leoy32255/SmartCar/.scratch/f407-classroom-baseline/spec.md

# F407 硬件基线与课堂验收澄清

Status: resolved

本文件的 resolved 仅表示需求澄清完成，不表示实现或实物验收完成。

## 用户已确认

- 主控改为 STM32F407VET6；材料已购买。
- 当前仓库为旧方案初版代码；期望课前完成软件准备，下次课组装并烧录。
- 本轮提取证据、澄清硬件基线与验收目标；未执行烧录、电机运行或固件修改。
- 第二轮确认：按修订3购买对应材料；此前图纸可行性问题由用户确认可行，记录为用户确认而非本代理实测。
- 所需材料课前可获得，但目前在另一位组员手中；用户当前只能做软件工作。
- 下次课约一周后、135分钟，不要求该节课全部完成。
- 课程未限制技术路线；赛道尚无正式规格，早期白底黑线、急弯和交叉路口描述可作候选场景。
- 希望性能较高并支持下学期扩展，扩展具体内容尚未给出。
- Windows/Mac均可用，当前Windows编写代码；电脑烧录、蓝牙指令控制；所有程序在当前仓库。

## 第二轮图片证据

- 核心板商品图标注 STM32F407VET6、168MHz、512KB Flash/192KB SRAM、8MHz HSE、32.768kHz LSE、W25Q16、SD/TF、Type-C 5V、DFU及SWD；图中可见PA0用户按键。这些属于商品资料证据，非上板验证。
- 电源图同时列两种与三种电压版本；下方实物示意是两种电压版本，标注输入6–24V、5V最大3A、3.3V最大1A。尚不能把三电压版3.3V最大3A套用到实物。
- 商品图没有提供核心板完整原理图或板载器件引脚占用，不能仅凭“全IO引出”排除占用。

## 已确认的交付与验收约定

用户已逐项同意第二轮Q1–Q5，并确认只有Type-C DFU，没有独立下载器。

- 优先级：可靠性 → 急弯/路口能力 → 速度。固定现有物料，确认硬件限制后才讨论增购；下学期未知功能仅保留接口。
- Windows为首个控制端验收平台；Mac保持可移植，后续实际验证。上位机包括连接、启动/停止、低速遥控、参数调整、状态显示、日志保存，程序均在本仓库。
- IMU先完成读取、校准和日志，基础闭环稳定后再加入短时航向辅助。
- 上电/复位保持停止；所有运动模式控制心跳中断500ms后停车，故障解除后必须人工重新启动。
- 首次联调丢线即停车；后续再单独启用限时低速搜线。必要传感器或共享总线异常停止运动；IMU未参与控制时允许报错后继续诊断。
- 软件停车请求与实际机械停车分开验证；500ms为心跳超时，不能当作车体停止时间。

### 课前软件交付目标

1. 与修订3一致的F407工程、真实依赖、可重复交叉编译及固件产物；修复驱动/定时器/协议等已知差异。
2. 控制和协议的有意义主机测试，覆盖停止优先级、心跳超时、异常锁存与人工重启等行为。
3. Windows蓝牙控制面板及无硬件条件下的协议/模拟验证。
4. DFU烧录说明、现场逐项测试表、参数与日志记录方式。
5. 分别报告主机测试、交叉编译、DFU烧录、台架和实车状态；无硬件时不声称后面三项通过。

### 首次课堂135分钟预算

| 时间 | 验收阶段 |
|---|---|
| 0–40分钟 | 组装、接线与供电检查 |
| 40–65分钟 | DFU烧录、复位保持停车、蓝牙连接及状态回传 |
| 65–100分钟 | 五路黑白读数、IMU数据、双轮方向及编码器正负 |
| 100–125分钟 | 架空低速控制、停止与失联测试 |
| 125–135分钟 | 保存参数、日志和问题；有条件再低速落地 |

前一阶段未通过即排查，不为赶进度跳过。首次课不强制完成跑圈。

### 后续赛道目标

- 自建直线、S弯、左右急弯、十字路口场景；记录线宽、弯曲半径、安装位置及高度。
- 普通闭合线路连续3圈不人工扶正。
- 左急弯、右急弯和十字直行分别10次至少成功9次。
- 十字默认直行，无路线指令的T字路口停车；须实现并验证识别，不能把全黑直接等同十字或T字。
- 达标后逐步提速，记录最快可靠速度；尚无固定速度承诺。

### 下载路径与待实物核验项

- 首次下载采用Type-C USB DFU；无ST-Link，不依赖断点/单步调试完成验收。
- 优先采用芯片系统存储器中的ROM bootloader，应用固件不以自带USB DFU类为前提。仓库旧移植文档关于必须生成DFU应用的说法需在实现阶段纠正。
- 对照ST AN2606与板级资料核对BOOT配置、复位及USB连接方式；商品图未明确具体跳帽/按键操作，不编造操作序列。
- 现场验证USB数据线、DFU枚举、下载校验及恢复Flash启动；按接线图供电约束操作，USB与外部5V不直接并供。
- 待核验清单：板载器件引脚占用、BOOT操作、电机CPR/方向、传感器极性/顺序、实际电源版本与负载表现、蓝牙串口枚举。这些是现场证据缺口，不再当作未回答的需求问题。
- 旧1320 counts/rev仍是待确认参数；不能据此承诺实际rpm或线速度。

## 证据与版本边界

- 指定 PDF：`D:/WeChat/xwechat_files/wxid_2vf8q9fo1rgz22_378a/msg/file/2026-09/智能三轮循迹小车_逐引脚接线图(1).pdf`，1页，标题 XY-160D 修订3，2026-09-24。已提取文字并检查整页图像。
- PDF 是设计资料：其中接线、阈值和调试步骤不等于已购物料规格或实测结果，也不构成执行上电的授权。
- 同目录采购清单仍含 F103ZET6/ICM-42688-P 等候选；V2 文档是 F103/TT 电机/双排模拟循迹的更早方案，不能混入本轮基线。
- PDF 提到的《兼容性核查与接线说明.md》在仓库与该附件目录未发现；实板原理图、XY参数图、电机六线原图尚未取得。

## 源码与图纸差异

| 项目 | 当前源码 | 指定图纸 |
|---|---|---|
| 电机驱动 | TB6612，STBY PB1，方向 PB12..15 | XY-160D，方向 PE10/PE8/PE12/PE13；无该 STBY 接线 |
| PWM | TIM1 PA8/PA9，20kHz | TIM1 PE9/PE11，2kHz，PSC83/ARR999（168MHz条件下） |
| 编码器 | TIM2 PA0/PA1，TIM3 PA6/PA7 | TIM3 PC6/PC7，TIM4 PD12/PD13 |
| 控制节拍 | TIM4，5ms | TIM4 已分配右编码器，节拍资源须重分配 |
| 循迹 | PB5..PB9 直接 GPIO | MCP23S17 GPA0..4，经 SPI2；CS PE7 |
| IMU | 软件 SPI PA4/5/11/12，INT PB0 | SPI2 PB13/14/15，CS PB12，INT PB10 |
| 蓝牙 | USART2 PA2/PA3，9600 | USART2 PD5/PD6，9600/8N1 |
| 人机 | PC13 LED、PB10 蜂鸣器；无启动按键实现 | 保留 PA0 按键、PA1 LED，未分配蜂鸣器 |

源码定位：`Core/Inc/bsp_config.h`、`Core/Src/bsp_config.c`、`motor.c`、`track.c`、`app.c`、`Makefile`。

## 已确认的软件准备缺口

- Makefile 默认 F1；F4 分支存在但仓库未包含 Drivers、启动文件、链接脚本、HAL配置和系统/时基支撑文件。
- OpenOCD 烧录目标仍写死 stm32f1x；不能据 F4 宏分支宣称可烧录。
- 电机驱动行为和循迹读取路径需适配，不能仅换引脚宏。
- 当前 PWM 把 0..1000 直接写入 CCR，与 F4 20kHz 的 ARR8399 不同标度。
- 上电默认 STOP；遥控未见失联超时；丢线/全黑处理不是完整路口策略。

## 首轮问题记录（已由后续回答收敛）

1. 修订3与实购物料是否一致；核心板准确型号/原理图、电机规格及XY版本证据在哪里。
2. 图纸标注待确认的XY参考供电、电池能力等是否已有实物或厂家验证。
3. 课程是否接受 MCP23S17 转接五路数字循迹作为 SPI 循迹，IMU的必验功能是什么。
4. 下次课日期、时长和必须达到的最高验收层级；课前可以接触哪些实物。
5. 实际赛道几何及路口/终点规则；旧V2规则不自动继承。
6. 现场下载器、操作终端与启动/停止方式。

## 验证状态

本轮仅文档与源码静态取证及DFU官方资料核对。主机测试、真实F4交叉编译、烧录、台架及实车验证均未执行。用户已确认工作基线、课堂指标和故障策略；固件实现属于后续工作。

## Comments

- 2026-09-29：建立首轮证据记录；按 grilling 逐轮澄清，答案确认后更新基线及领域术语。
- 2026-09-29：录入用户首轮六项回答及两张商品图；修订3作为当前硬件工作基线，验收标准仍待第二轮确认。
- 2026-09-29：用户同意第二轮Q1–Q5，确认仅Type-C DFU。需求澄清完成，保留现场核验项；未修改固件。
