leoy32255/SmartCar/.scratch/unified-bringup-guide/spec.md

# 统一新手联调流程

Status: resolved

## 目标与边界

整理 docs，形成一份不依赖旧文档阅读经历、也不预设单片机经验的完整操作流程。以当前 F407 源码、修订3 PDF、2026-10-20 用户补充为准；保留历史证据并隔离过时操作。更新 README 与旧入口，不修改无关编辑器配置或 vendor 检出目录。不执行烧录、电机运行、提交或推送。

## 当前用户确认

- 已下载 STM32CubeMX 和 STM32CubeProgrammer，Programmer 尚未检测到核心板。
- 旧线连接出现 U 盘，新数据线已购买但尚未测试。
- 核心板型号 STM32F407VET6；核心板只有孔，未焊排针。
- 各模块及模块、核心板、电脑间的连接尚未实施；部分接口缺适配线。
- 有万用表、ST-Link V2、焊接工具；USB 转 TTL 模块似乎没有，可按需购买。
- 商家表示不懂，未取得可用的 BOOT/DFU 操作说明。
- ST-Link 具体实物针序、供电脚性质、缺线接口、模块实际供电/输出电平与板载占用仍待核验。

## 验收

1. 一份主指南覆盖当前状态、术语、线材与焊接、工具配置、SIM、裸板下载、真实通信、供电、完整接线、传感器、电机与赛道，按前提/动作/预期/失败停点推进。
2. 现行主入口没有 F103/TB6612 或旧里程碑操作；历史记录有日期与适用范围。
3. 引脚、参数与 GUI 按钮同源码；USB DFU、SWD 下载和 USART2 通信分清。
4. 主机测试、交叉编译、历史 UI 反馈与未做的硬件验证分开记录；检查文档链接及归档完整性。

## Comments

- 并行只读文档与源码审计完成；未发现本任务必须修改的功能代码。
- 修订3 PDF 已检查完整单页与文字；商品图仅作板卡资料，不替代实物针序或 BOOT 电路。
- 已完成统一流程、README导航、集中引脚表、14份历史原文快照与11个旧入口转向；本任务不删除历史证据。
- 新手审阅发现原面板未显示device_ms/deviation，已补两项只读显示，并标明请求PWM不是实际电气回读。无固件逻辑修改。
- 独立审阅提出的阶段供电依赖、诊断灰按钮/拒绝验证、丢线故障验证阶段、无示波器时序边界均已修正。
- make -j8 test 22项通过；本次双固件已最新未全量重编。新增显示的脚本语法和render读数检查通过；浏览器工具不可用，新增UI未做实际渲染验收。详细边界见主流程第12节。
- 2026-10-20用户随后反馈4.2工具版本正常、4.3全部OK、4.4完成并提供SIM快照。已核对快照和同日会话日志，原样保存截图/快照，更新阶段B为完成；参数写入及具体焦点操作仅据用户反馈，未混称独立复现。硬件阶段不推进为已完成。
