leoy32255/SmartCar/CONTEXT.md

# 智能三轮循迹小车

本项目面向双驱动轮加万向支撑轮的小车，完成循迹与电脑蓝牙控制，并为后续课程扩展保留空间。

## Language

**硬件基线**：本轮开发采用的已购物料与对应接线方案，当前以用户确认的修订3为准。采用方案不等于完成实物验证。

**课堂验收**：在课堂实物条件下，按约定步骤观察并记录模块或整车是否满足目标；可分多次课完成。
_Avoid_: 编译通过即验收通过

**循迹模式**：由线路传感器观测引导小车沿地面线路行驶的工作模式。

**遥控模式**：由电脑通过蓝牙下发运动指令控制小车的工作模式。

**课前软件验证**：在未连接小车实物时对程序逻辑与固件构建进行的验证，不包含电机、传感器或赛道表现。
