leoy32255/SmartCar/docs/课堂135分钟检查表.md

# 课堂检查表：入口已合并

当前操作、工具配置、接线、下载、面板使用及测试记录统一见[上手与实物联调流程](上手与实物联调流程.md)。从当前进度开始执行即可，无需先读旧说明。

本页保留旧链接入口。[原文历史快照](archive/2026-10-20/课堂135分钟检查表.md)仅供追溯原阶段证据，不作为现行操作步骤。
