leoy32255/SmartCar/docs/archive/2026-10-20/F407电机驱动迁移.md

> 历史快照：2026-10-20整理时归档，保留原阶段状态；下文不代表当前操作流程。当前执行请读[统一流程](../../上手与实物联调流程.md)。原正文保留，文档链接仅调整为归档后的可达路径。

# F407 板级与 XY-160D 电机驱动迁移

日期：2026-10-05。任务：`.scratch/f407-classroom-baseline/issues/02-board-motor.md`；
依赖已resolved的01最小构建。本轮只完成板级/电机接口，未接入闭环、传感器驱动、
运动协议、500ms心跳或人工故障重启状态机，也未执行烧录或电机操作。

## 前两步核对

已读取硬件spec、01任务和2026-09-29构建记录，并重新提取/检查修订3PDF整页。
附件图中的步骤是开发顺序；PDF中的接线与调试步骤作为设计证据，不是本轮上电授权。
外部指定spec与工作树spec的需求一致；初始工作区干净。

- 已有：真实HAL/CMSIS、F407启动/链接、8MHz HSE至168MHz、修订3引脚、唯一IRQ归属。
- 冲突已解决：TIM1专属PWM，TIM3/TIM4左右编码器，TIM6 5ms控制节拍，SysTick仅HAL 1ms。
- 变更前当前工作目录真实重建成功，原有5项测试通过，Flash7172B、普通SRAM2528B。
- 原有缺口：只有11/PWM0初始化，无XY-160D运行接口；旧TB6612驱动不编入F407。
- 保留现场证据缺口：核心板占用、BOOT、XY参考电压/信号电平、电源、电机CPR与方向。

## 接口与输出约定

`motor.h` 在F407选择 `motor_f407.h` / `Core/F407/motor.c`；旧F1驱动与接口保持原样。
配置集中在 `bsp_config.h` 转入的 `bsp_f407.h`，驱动不使用旧STBY或蜂鸣器引脚。
所有接口在 `Bsp_Init()` 完成后由主循环串行调用，不在ISR并发调用。

| 调用/输入 | 行为 |
|---|---|
| `Motor_Init()` / `Motor_Stop()` | 两轮11/PWM0，撤销使能并清除记录 |
| `Motor_Enable(0)` | 同Stop |
| `Motor_Enable(1)` | 允许新指令，不恢复被丢弃的指令；重复使能不改变当前输出 |
| 禁用时 `Motor_SetPWM(left,right)` | 丢弃指令，保持停车 |
| 单轮0或绝对值1..49 | 该轮11/PWM0，不将小指令放大成5% |
| 绝对值50..950 | 原值输出，即5%..95% |
| 绝对值951..32768 | 限制为950，含INT16_MIN，不溢出取负 |
| 正/负指令 | 默认方向10/01；这是软件极性约定，车前进方向需实物校准 |
| `Motor_GetPWM` | 返回限幅后的带符号指令（方向校准前），不是测速；允许空指针 |

`BSP_MOTOR_LEFT_INVERT` / `BSP_MOTOR_RIGHT_INVERT` 默认为0，各自可改为1。
左右PE10/PE8、PE12/PE13控制方向，PE9/PE11提供TIM1_CH1/CH2 PWM。
`PSC=83, ARR=999`，168MHz /84 /1000 = 2kHz。
千分比按 `abs(command)*(ARR+1)/1000` 转换，因此50/950对应CCR50/950。
暂不提供100%或00动态刹车接口；停车采用图纸要求的11高阻滑行，机械减速时间待实测。

## 换向与停机

HAL开启OC比较预装载，单写CCR0并不保证旧占空比立即失效。任一轮方向状态改变
（含零与非零转换）时，先同时置两轮11，再写两路CCR0并发TIM1 UG刷新零值。
之后才选择新的10/01方向、写新CCR；新占空比在后续自然更新事件生效。
因此这类操作会短暂中断另一轮PWM；相同方向的调速不发UG、不重置PWM相位。
本实现不承诺固定机械换向等待时间，也不把软件顺序当成实测的电气死区。

`Bsp_MotorStop` 是低层初始化/驱动助手，不更新电机软件状态；应用停止须调用
`Motor_Stop`。`Error_Handler` 仍关中断并强制方向11、PWM GPIO0后停留。
上电至软件执行前的状态仍依赖图纸的外部方向上拉。

主程序只调用 `Motor_Init` 后等待中断，不调用Enable/SetPWM。ARM编译器编译完整
`motor.o`；链接器按 `--gc-sections` 删除默认固件未引用的使能/运动函数。
该产物仍是停车诊断固件；未来控制集成须显式调用接口并实现spec规定的安全策略。

## 验证记录

- 用户确认测试接口：电机公开API到方向/PWM、限幅、零值、默认禁用/重新使能；
  沿用板级初始化和构建产物接口。审查基线为 `4be551ed7bd65c7d99cf03c5ba6589a57f0cdfb0`。
- TDD：默认禁用测试先因缺少API链接失败；方向/限幅测试先因输出不符失败；
  换向刷新测试先因缺少UG失败；实现后相应测试通过。
- 初次运行失败断言触发MinGW/Windows异常弹窗，该次返回状态不足以证明测试完成。
  已改为非交互错误退出、捕获输出、20秒超时和完成标记检查，并实际复现断言失败退出1。
- 主机执行真实BSP/电机源码，使用ST类型与模拟HAL/MMIO；方向写入处检查无00瞬态，
  且选新方向前两CCR为0并已请求UG。四种左右极性组合均执行同一行为测试集。
  不执行真实HAL硬件逻辑，不模拟模拟电路或定时器波形，不能证明电气安全/物理时序。
- `make -j8 test`：9项通过（1项板级、4项电机极性组合、3项产物、1项依赖完整性）。
  主机编译器MinGW GCC8.1，电机测试使用 `-Wall -Wextra -Werror`；未以跳过计为通过。
- 真实交叉编译：GCC for STM32 14.3.1，Cortex-M4硬浮点，真实71个固定ST依赖，
  `make -j8` 成功，无新增编译/链接警告。未用 `.ci_check` 桩替代固件构建。
- ELF/HEX/BIN/MAP位于 `build/F4`。Flash7220/524288B，普通SRAM2536/131072B
  （含2048B栈预留），CCM0。BIN7220B，SHA-256
  `4ede02f8c06120dd0203622aa105087268e2d6ddaee88caac845b5b53ef5e525`。
  ELF SHA-256 `3cde28414105a67eb04f7f2959fc7a18b1aaeaae95b9ad2d3719a3973390c7ff`
  （包含本地调试路径）。本轮未额外宣称独立导出/跨机复现。

## 双轴代码审查

两个独立只读审查，以 `4be551ed7bd65c7d99cf03c5ba6589a57f0cdfb0` 为固定基线。
因提交阶段遇到工作树元数据权限/默认Git身份问题，审查使用
`git diff 4be551ed7bd65c7d99cf03c5ba6589a57f0cdfb0 -- .`（含已暂存新增文件和工作区修正），
未将空的提交差异送审。审查员未独立运行测试或硬件；执行结果来自上文主代理记录。

### Standards

0项。未发现违反AGENTS.md、当前F407模块边界、集中配置及验证证据要求的变更，
也没有值得要求修改的代码异味。核对了F1接口保留、配置集中、停机与换向刷新顺序、
同方向调速保留相位，以及主机模拟和实物验证的区分。

### Spec

0项。未发现本票范围内的要求遗漏、越界或实现错误。核对了TIM6/TIM3/TIM4归属、
2kHz与接线、限幅/极性、默认禁用、Stop与重新使能、换向旧PWM刷新、诊断主程序边界。
运动协议、传感器和闭环属于后续任务；未把这些作为本票遗漏。

合计Standards 0项、Spec 0项，无未处理审查发现。

## 待实车验证

1. 核对XY版本允许的3.3V参考供电、引脚占用、方向外部上拉及信号电平。
2. 逻辑供电下检查上电/复位/异常路径的11与ENA0，再用示波器量两路2kHz、5%/95%及换向过程。
3. 架空逐轮低占空比确认左右通道、10/01对应的实际方向、停机滑行与重新使能行为。
4. 手转编码器核对AB方向/CPR，测TIM6节拍与编码器并行工作；闭环留给后续任务。
5. 按已有ROM DFU文档核验板级BOOT操作、枚举/下载/恢复启动。上述项目本轮均未执行。
