leoy32255/SmartCar/docs/archive/2026-10-20/Windows控制面板.md

> 历史快照：2026-10-20整理时归档，保留原阶段状态；下文不代表当前操作流程。当前执行请读[统一流程](../../上手与实物联调流程.md)。原正文保留，文档链接仅调整为归档后的可达路径。

# Windows控制面板

实现位于panel/。这是本机浏览器界面与Python串口后端，不依赖云服务。默认SIM，真实蓝牙使用Windows配对产生的SPP COM口。Mac保留Python/浏览器可移植性，本轮未验证。

## 启动

在仓库根目录使用Python3和本机GCC：

```powershell
python -m pip install -r panel/requirements.txt
python tools/build_simulator.py
python -m panel.server --port 8765
```

HOST_CC可指定GCC路径（见F407最小构建）；SIM需要先生成build/host/smartcar_sim.dll。实际COM仅需要pyserial，不依赖模拟器。打开`http://127.0.0.1:8765`，单个浏览器标签使用；不要同时打开多个控制页面。后端仅绑定127.0.0.1，不向局域网开放。停止服务用终端Ctrl+C；本任务未连接真实COM。

1. 首先选择SIM并连接；连接会发STOP并请求参数，等待实时遥测。
2. 启动循迹或启用低速遥控。遥控按钮按住发送±5 counts/10ms或单轮0/5，松开归零；固件最多接受±10。请勿据此解释为已标定物理低速。
3. 红色停止按钮发STOP；界面以设备遥测显示实际模式，ACK只说明接受/拒绝。
4. 仅停车时调参；应用后请求实际值回读。静止校准需有效IMU样本。
5. SIM可以注入丢线、总线失败、宽线歧义。先恢复传感器，再人工清错，最后重新启动。关闭“发送控制心跳”可验证500ms锁存停车。
6. 断开/重连保持停止。切出页面、隐藏或关闭会尝试STOP并停止页面心跳；网络请求失败时仍依赖固件心跳超时。不要把浏览器发出STOP视为机械已停。

浏览器每100ms请求一次心跳和状态，后端不自行持续发心跳。模拟器复用Core/F407/control.c和runtime.c；轮速为理想目标反馈，不模拟电机、传感器电气或无线链路。控制器与真实App测试另有独立覆盖。

## 日志和参数

每次连接自动建立`logs/日期-时间-微秒.jsonl`；每行一个UTF-8 JSON对象，包含UTC time与kind。connect记协议/固件系列及端口，command记命令字和十六进制载荷，rx记原始帧载荷，telemetry记模式/故障/五路/编码器/IMU原始及零偏，parameters记六项实际参数，disconnect记结束。日志自动flush，目录被gitignore忽略；写入失败显示错误并停止本地发送。日志会话头不证明实际烧录版本，须在课堂表另记BIN哈希。

“保存参数快照”下载JSON（含当前遥测、参数、端口、日志路径与时间）。设备参数仅在RAM，复位恢复app_config_f407.h默认值。将已验证参数抄入课堂模板，确认后再改源码默认；不要把未验证值标为标定结果。

## 排错

- SIM加载失败：先运行build_simulator.py，检查HOST_CC/平台位数；不要把缺库当串口故障。
- 端口列表只有SIM：检查pyserial安装、Windows配对与SPP枚举；刷新列表。未枚举不是固件协议结论。
- 命令拒绝：查看故障、样本新鲜度、当前模式、参数范围；先停车/恢复条件/清错，再人工启动。诊断固件永远拒绝运动模式。
- 无遥测/数据显示过期：面板500ms无有效遥测标过期并禁止启动；检查COM、9600/8N1、帧版本。切勿盲目反复启动。

## 验证状态

2026-10-08最终状态：用户已反馈Windows SIM清单1–6通过；第一次取消心跳时已停止，所以无心跳故障符合运动模式超时检测语义，第二次运动中超时符合预期。日志时序、参数快照与四组同源C模拟器定时复现已核对，未发现需要修复的功能缺陷。05/06标记resolved。此为用户界面实测与代理自动验证的合并证据，代理未亲自完成浏览器操作，浏览器名称/版本未知。源码仍为4c90a5b；此前22项自动软件验证、双目标构建及独立导出BIN/HEX一致性证据有效，本次仅文档收尾，不重复测试。真实蓝牙、DFU、台架和实车未验证；未推送、未烧录、未运行电机。 详细日志与复现见[心跳取消差异诊断](心跳取消差异诊断.md)。

### 历史：2026-10-07 用户分批实测进度（后续已完成）

用户反馈已在VS Code运行PowerShell命令并打开URL，步骤1–3可以完成。记录为用户实测反馈，说明本机页面已可访问；不是代理亲自操作或逐项采集的证据。步骤4–6尚待结果，浏览器名称/版本待补充，不关闭整体UI验收。

### 步骤4–6详细操作与通过标准

全程只选SIM，保持单个控制页面。以“设备状态”的遥测为准，不能只看“命令已接受”。每个场景开始前勾选“发送控制心跳”、点击“恢复传感器”，必要时“清除故障”。

#### 4. 停车调参、校准和快照

1. 点击“停止”，确认模式为“停止”、PWM为`0 / 0`。
2. 在“停车调参”选择“基础速度”，记下参数区的原值。输入不同的有效值（例如原值5改为6），点击“应用并回读”。
3. 确认下方“基础速度”更新为输入值，再按同样方法恢复原值。全过程应保持停止。
4. 点击“静止校准”，确认IMU区显示“校准：完成”。SIM只验证操作流程，不代表真实IMU校准；不要求观察到短暂的“进行中”。
5. 点击“保存参数快照”，确认下载`smartcar-parameters.json`，打开后确认包含参数、状态、SIM端口与日志路径。打开下载文件可能使页面失焦并请求停车，属预期。

#### 5. 故障锁存和心跳超时

每个故障场景都先“启动循迹”，确认模式为“循迹”，再点击下表故障按钮。

| 故障按钮 | 预期故障显示 | 停车结果 |
|---|---|---|
| 丢线 | 丢线 | 模式停止，PWM为0 / 0 |
| 共享总线故障 | 传感器失效 | 模式停止，PWM为0 / 0 |
| 宽线 / 路口歧义 | 线路歧义 | 模式停止，PWM为0 / 0 |

每次故障后依次检查：点击“恢复传感器”后故障仍保留且仍停车；点击“清除故障”后显示“故障：无”但仍停车；只有再次“启动循迹”后才能恢复循迹。三个场景分别重复完整流程。

心跳场景：正常循迹时取消勾选“发送控制心跳”，保持页面前台等待约1–2秒；应显示“停止”、PWM为`0 / 0`及“心跳超时”。重新勾选心跳后故障应仍锁存；清除故障后仍停止；人工启动后才恢复。肉眼操作验证超时停车及锁存，不用于证明精确500ms时序。

#### 6. 重连与切换窗口

| 场景 | 操作 | 通过标准 |
|---|---|---|
| 断开重连 | 启动循迹→断开→连接→等待“实时” | 遥测模式为停止，PWM为0 / 0，不自动启动 |
| 切换窗口 | 启动循迹→切换到VS Code等待2秒→返回页面 | 模式为停止，PWM为0 / 0，不自动恢复；若出现心跳超时，另行记录并清错 |

测试结束点击“停止”。另检查页面显示的日志路径对应文件存在且非空；具体日志字段定义见“日志和参数”。

#### 结果记录（未填不代表通过）

```text
操作者／日期：
浏览器名称／版本：
1–3：用户已反馈可以完成
4：参数回读___；恢复原值___；校准___；快照下载及内容___
5：丢线___；总线故障___；宽线歧义___；心跳超时___
   恢复传感器不启动___；清错不启动___
6：重连保持停止___；切换窗口后保持停止___
日志文件存在且非空___
失败项的操作及实际显示：
```

### 最终验收结果（2026-10-08整理）

用户已反馈1–6通过，包括参数回读/校准/快照、故障模拟、运动心跳超时、重连与切换窗口。第一次取消心跳时已停止，不新增心跳故障符合预期。操作者为用户，浏览器名称/版本未提供。代理核对的快照采集于2026-10-07 22:41:10.843（北京时间），SIM、mode0/fault0、PWM0/0、health7、参数[4,20,5,20,2,0]；[原样验收附件](../../reference/smartcar-parameters-20261007.json)。原始日志保留于logs，时序摘录及四组定时复现见[诊断记录](心跳取消差异诊断.md)。上方空白结果模板供后续验收复用，不表示此次用户实测仍未完成。
