leoy32255/SmartCar/docs/archive/2026-10-20/引脚分配.md

> 历史快照：2026-10-20整理时归档，保留原阶段状态；下文不代表当前操作流程。当前执行请读[统一流程](../../上手与实物联调流程.md)。原正文保留，文档链接仅调整为归档后的可达路径。

# STM32F407VET6 修订3引脚分配

当前配置入口：`Core/Inc/bsp_config.h` → `bsp_f407.h`，实现 `Core/F407/bsp.c`。依据2026-09-24 XY-160D修订3接线图与用户确认spec；以下配置尚未实物验证。

| 功能 | 引脚 | 当前配置 |
|---|---|---|
| 左/右PWM | PE9 / PE11 | TIM1_CH1/CH2，AF1，2kHz，默认CCR=0；驱动限幅5%–95% |
| 左方向1/2 | PE10 / PE8 | 普通输出，默认11高阻停车；驱动10/01 |
| 右方向1/2 | PE12 / PE13 | 普通输出，默认11高阻停车；驱动10/01 |
| 左编码器A/B | PC6 / PC7 | TIM3_CH1/CH2，AF2，TI12 |
| 右编码器A/B | PD12 / PD13 | TIM4_CH1/CH2，AF2，TI12 |
| 共享SPI2 SCK/MISO/MOSI | PB13 / PB14 / PB15 | AF5，Mode0，656.25kHz |
| IMU CS / INT | PB12 / PB10 | 默认CS高，事务时拉低；INT使用EXTI15_10的line10 |
| MCP23S17 CS | PE7 | 默认高，事务时拉低；MCP全输入上拉及五路采样 |
| 蓝牙TX/RX | PD5 / PD6 | USART2 AF7，9600/8N1 |
| 循迹OUT1..5 | MCP23S17 GPA0..4 | 外部接线，后续驱动只使用低5位；不再用PB5..9 |
| 保留 | PA0、PA1、PA11/12、PA13/14、晶振 | 本目标不配置按键、LED、USB、SWD及晶振GPIO |
| 控制节拍 | TIM6，无输出引脚 | 5ms；TIM4专属右编码器 |

无STBY和蜂鸣器接线。上电安全顺序、时钟与IRQ优先级见 [F407最小构建](F407最小构建.md)。板载器件占用、XY参考供电及信号电平仍需现场核验；不把引脚配置成功当作电机停车实测。

## 以下为历史F103配置，不适用于修订3

# STM32F103C8T6 引脚分配表（历史）

> 本文档与 `Core/Inc/bsp_config.h` 中的宏**一一对应**。
> 改引脚时先改 `bsp_config.h`，再同步改本文档，代码逻辑不需要动。

## 一、总表

| 功能 | 引脚 | 外设 / 模式 | 说明 |
|---|---|---|---|
| HSE 晶振 | PD0 / PD1 | OSC_IN / OSC_OUT | 8MHz，PLL×9 = 72MHz |
| SWD 调试 | PA13 / PA14 | SWDIO / SWCLK | **保留，勿占用** |
| **电机驱动** | | | |
| 左电机 PWM | PA8 | TIM1_CH1，复用推挽 | 20kHz |
| 右电机 PWM | PA9 | TIM1_CH2，复用推挽 | 20kHz |
| 左电机方向 AIN1 | PB12 | GPIO 推挽输出 | |
| 左电机方向 AIN2 | PB13 | GPIO 推挽输出 | |
| 右电机方向 BIN1 | PB14 | GPIO 推挽输出 | |
| 右电机方向 BIN2 | PB15 | GPIO 推挽输出 | |
| TB6612 **STBY** | PB1 | GPIO 推挽输出 | **高电平才工作** |
| **编码器** | | | |
| 左编码器 A / B | PA0 / PA1 | TIM2_CH1 / CH2 | 输入浮空，正交 4 倍频 |
| 右编码器 A / B | PA6 / PA7 | TIM3_CH1 / CH2 | 输入浮空，正交 4 倍频 |
| **姿态（软件 SPI）** | | | |
| MPU6500 CS | PA4 | GPIO 推挽输出 | 低有效 |
| MPU6500 SCLK | PA5 | GPIO 推挽输出 | 模式 3，空闲高 |
| MPU6500 MISO | PA11 | GPIO 上拉输入 | |
| MPU6500 MOSI | PA12 | GPIO 推挽输出 | |
| MPU6500 INT | PB0 | EXTI0 上升沿 | 数据就绪 |
| **循迹** | | | |
| 循迹 OUT1（最左） | PB5 | GPIO 上拉输入 | 黑线 = 低电平 |
| 循迹 OUT2 | PB6 | GPIO 上拉输入 | |
| 循迹 OUT3（中间） | PB7 | GPIO 上拉输入 | |
| 循迹 OUT4 | PB8 | GPIO 上拉输入 | |
| 循迹 OUT5（最右） | PB9 | GPIO 上拉输入 | |
| **通信与人机** | | | |
| 蓝牙 TX → MCU RX | PA3 | USART2_RX | 输入浮空 |
| 蓝牙 RX ← MCU TX | PA2 | USART2_TX | 复用推挽 |
| 蜂鸣器 | PB10 | GPIO 推挽输出 | 高电平响 |
| 状态指示灯 | PC13 | GPIO 开漏输出 | 低电平亮 |

## 二、与原设计文档的差异说明

原《硬件设计方案》的引脚表有几处会导致**实际不工作**，本工程做了修正：

### 1. 补上了 TB6612 的 STBY（新增 PB1）

原文档完全没有提到 STBY。TB6612FNG 的 STBY 引脚：
- **低电平 / 悬空 → 整个芯片关断**，IN1/IN2/PWM 怎么给都不转
- 高电平 → 正常工作

这是"接线全对但电机不动"最常见的原因。代码里由 `Motor_Standby()` 控制，
上电默认关断（安全），进入循迹/遥控模式时自动拉高。

### 2. 解决了 PA6/PA7 的外设争用

原文档同时把 PA6 分配给 TIM3 编码器和 SPI1_MISO，自己在表里也标注了冲突。
本工程按"IMU 走软件 SPI"解决：

- 右编码器保留 PA6/PA7（TIM3 硬件正交，4 倍频，不能省）
- IMU 改用软件 SPI，占用 PA4/PA5/PA11/PA12 四个纯 GPIO

代价是 SPI 速率从硬件 SPI 的 ~10MHz 降到 ~3MHz 量级。
但 MPU6500 一次突发读 14 字节只需约 40μs，5ms 周期里占 0.8%，**完全够用**。

### 3. 循迹从 PB6~PB9 调整为 PB5~PB9

5 路模块需要 5 个 IO，原文档只留了 4 个。把 PB5 也划给循迹
（原文档的蜂鸣器移到 PB10）。

### 4. 波特率按模块实际出厂值改为 9600

原文档写 115200，但 JDY-31 出厂默认是 **9600**。
直接按 115200 通信会全是乱码。代码默认 9600，
要改 115200 需先给模块发 `AT+BAUD8\r\n` 永久保存，再改 `COMM_BAUDRATE`。

## 三、避开的复用冲突（设计时已核对）

| 引脚 | 冲突风险 | 处理 |
|---|---|---|
| PB3 / PB4 | JTAG 的 JTDO / NJTRST | **未使用**，避免额外关 JTAG |
| PA15 | JTAG 的 JTDI | **未使用** |
| PB2 | BOOT1，多数板上有下拉电阻 | **未使用**（会影响启动模式） |
| PC14 / PC15 | 32.768kHz 晶振脚 | **未使用**（本工程不用 RTC） |
| PA2 / PA3 | USART2，同时是 USB 相关 | 用作串口，不用 USB |
| PB6 / PB7 | 硬件 I2C1 | 用作普通 GPIO（循迹），不启用 I2C |
| PA0 / PA1 | 同时是 ADC 通道 | 用作编码器，不启用 ADC |

## 四、上电默认状态

初始化顺序刻意保证**上电时车不会乱动**：

1. `Bsp_Gpio_Init()` 先把 STBY 拉低 → TB6612 整片关断
2. `Bsp_Encoder_Init()` 编码器清零
3. `App_Init()` → `Motor_Init()` → `Motor_Standby(0)` + 两路滑行
4. IMU 校准（约 2.5 秒，此间心跳灯常亮）
5. 进入 `APP_MODE_STOP`，电机保持关断

只有收到上位机的 `SET_MODE` 指令（或以后加按键）才会开始动作。

## 五、接线注意事项（来自硬件方案文档 + 实测经验）

- **地线单点汇合**：电机动力地与 MCU 数字地在滤波电容负极单点相连。
  电机电刷火花会造成 MCU 复位，这是最常见的"跑着跑着死机"原因。
- **电机两端并联 104 陶瓷电容**，抑制高频干扰。
- **编码器线**：模块已内置 10kΩ 上拉，若线长超过 30cm，
  建议再加 100Ω 串联阻尼电阻。TIM2/TIM3 的输入滤波器已开到 10 个采样周期。
- **电源**：3S 电池（11.1~12.6V）→ 多路电源模块 → 5V 给 TB6612 的 VCC 和 JDY-31，
  3.3V 给 MCU / MPU6500 / 循迹模块。
  注意该模块 3.3V 输出上限只有 **1A**，5V 是 3A。
- **JDY-31 建议接 5V**（手册要求 3.6~6V），不要接 3.3V。
- **MPU6500 接 3.3V**，模块标称工作电压 DC3.5V 且内部有 LDO。
- **3.3V 只有 1A，接线时算一下**：F103C8T6 约 50mA，
  MPU6500 约 4mA，5 路循迹模块约 5×20mA = 100mA，
  合计不到 200mA，余量充足。但**不要把 5V 的外设误接到 3.3V 上**
  （比如 JDY-31 和 TB6612 的逻辑 VCC 都要 5V）。
- **换 F407VET6 后供电方式会变**：那块核心板是 Type-C 输入 5V、
  板载 3.3V 稳压，所以直接由电源模块的 5V 供电即可，
  不再消耗电源模块的 3.3V 通道。
