leoy32255/SmartCar/docs/archive/2026-10-20/心跳取消差异诊断.md

> 历史快照：2026-10-20整理时归档，保留原阶段状态；下文不代表当前操作流程。当前执行请读[统一流程](../../上手与实物联调流程.md)。原正文保留，文档链接仅调整为归档后的可达路径。

# SIM取消心跳差异诊断

执行与用户实测日期：2026-10-07；文档收尾：2026-10-08。时间均为北京时间。仅软件SIM，不涉及真实COM、烧录或电机。

## 结论与证据层级

用户确认第一次取消心跳时已停止，故障显示“无”；第二次运动中取消心跳符合超时停车预期。前者符合协议“所有运动模式”检测心跳的约定，不是第二次通过掩盖第一次失败。没有复现生产代码缺陷，不修改固件或页面代码。

用户通过协调对话反馈面板清单1–3可完成、4完成、5故障模拟及第二次运动心跳符合预期、6符合预期。这是用户实际操作证据；代理本轮只分析日志、参数快照并执行同源C模拟器定时验证，未亲自操作浏览器。浏览器具体版本未提供，不作推定。

## 日志时序

主文件：`logs/20261007-223922-288342.jsonl`。行号用于本地追溯；日志UTC时间已转换为UTC+8。mode 0/1/2为停止/循迹/遥控；fault 1为心跳超时。

| 行号 | 时间 | 记录 |
|---|---|---|
| 9290 | 22:45:38.719 | mode1、fault0、PWM8/8 |
| 9334–9337 | 22:45:40.136–40.211 | 收到STOP，遥测mode0、fault0、PWM0/0；随后心跳间隔25.784秒，未新增心跳故障 |
| 9927 | 22:46:08.311 | mode1、fault0、PWM88/88 |
| 9988–9991 | 22:46:10.312–10.412 | STOP后mode0、fault0、PWM0/0；下次心跳22:47:15.214，间隔64.991秒 |
| 11554–11595 | 22:47:26.614–27.913 | 循迹启动后又收到STOP，恢复mode0、fault0 |
| 11842 | 22:47:39.123 | mode1、fault0、PWM8/8 |
| 11936 | 22:47:42.417 | mode0、fault1、PWM0/0，距最后记录心跳约605ms，device_ms=500100 |
| 12677–12763 | 22:48:19.386–22.818 | 心跳尚未恢复时先清错；22:48:21.527心跳恢复，22:48:22.749再次清错后fault0，仍停止 |
| 12783–12786 | 22:48:23.438–23.518 | 新人工启动后才恢复mode1 |
| 12833 | 22:48:25.046 | 断开 |

邻近会话`223103-723300`同样在22:31:52.928收到STOP，随后42.103秒心跳间隔仍停止、fault0。重连会话`224825-880394`在22:48:26.013记录mode0、fault0、PWM0/0，22:48:49.455新启动后才恢复循迹，22:48:52.276再次STOP。

日志不记录勾选框、窗口焦点或STOP的具体UI来源，不能仅由这些记录确定哪次点击对应“第一次”；用户“当时已停止”的确认补足了这一事实。605ms是主机日志接收时差，包含遥测周期与调度，不能解释为固件阈值变成605ms或精确硬实时证明。

## 窄范围复现

使用`panel.device.Session`连接实际`build/host/smartcar_sim.dll`，以绝对模拟时间推进：10ms发送最后心跳；运动分支发送mode1/2并推进110ms；STOP分支在110ms发送STOP后推进120ms；全部推进700ms。断言最终mode0及PWM0/0，并分别断言fault。调用Python现场执行，结果如下：

```text
PASS initial_mode=0 STOP_before_timeout=False mode=0 fault=0 pwm=[0,0]
PASS initial_mode=1 STOP_before_timeout=True  mode=0 fault=0 pwm=[0,0]
PASS initial_mode=1 STOP_before_timeout=False mode=0 fault=1 pwm=[0,0]
PASS initial_mode=2 STOP_before_timeout=False mode=0 fault=1 pwm=[0,0]
```

此反馈循环可捕获“运动状态丢失心跳却不停车/不锁存”以及“停车状态错误新增心跳故障”。没有产生用户所担心的运动漏检，因此不进入假设修复阶段。首次使用系统临时目录因沙箱写权限失败，改用仓库build目录后四组均执行成功；失败尝试不计为验证通过。复现日志留在`build/heartbeat-diagnosis/`，未修改生产代码或新增临时调试埋点。原22项全套验证没有因纯文档收尾而重复执行。

源码复核：`Core/F407/control.c`的`Control_CheckTime`仅在mode非STOP时锁存到期故障。页面blur/pagehide/隐藏会尝试STOP；本次没有证据把具体STOP归因于某个窗口事件。参数快照`tmp/smartcar-parameters.json`时间14:41:10.843Z，SIM、mode0、fault0、PWM0/0、health7，params=[4,20,5,20,2,0]；这支持参数下载和当时状态，不替代完整时序日志。

## 收尾

结合此前22项自动软件验证、双目标真实交叉构建、独立源码导出验证、双轴审查关闭以及本次用户UI实测，软件任务05/06可关闭。真实蓝牙、DFU、台架、机械停车和实车赛道仍未验证；不推送、不烧录、不运行电机。

验收快照已原样复制至[reference附件](../../reference/smartcar-parameters-20261007.json)，tmp原件保留。05/06已于2026-10-08按上述证据关闭。
