leoy32255/SmartCar/docs/archive/2026-10-20/软件验收覆盖审计.md

> 历史快照：2026-10-20整理时归档，保留原阶段状态；下文不代表当前操作流程。当前执行请读[统一流程](../../上手与实物联调流程.md)。原正文保留，文档链接仅调整为归档后的可达路径。

# F407 修订3软件验收覆盖审计

日期：2026-10-06。审计基线：`09e2b89740f03e6554c4e4a2821ef1f5b45bd3c4`（简称 `09e2b89`）。

## 结论与范围

基线已具备修订3停车诊断工程、真实依赖、板级初始化和独立XY-160D电机接口；完整课前软件交付尚未完成。传感器采样、控制与协议、故障状态机、Windows面板和完整课堂交付包仍需任务03至06接续。

本轮是基线缺口审计，采用 code-review 的 Standards（项目规范）与 Spec（需求覆盖）两轴方法，不是变更回归审查，不将尚未实现的后续任务报告为已有代码回归。不对同目录实现对话的后续工作作结论；收到完成通知后另审最终版本与执行证据。

本轮只读源码、配置、测试和资料，仅新增本文；未运行构建、主机测试、面板、烧录或硬件，不提交、不推送。开始时HEAD为上述基线，工作树已有交付安排、reference及vendor临时目录未跟踪项，均保留。报告中的“已实现”指静态可定位，“历史通过”指已有交付记录，均不等于本轮重新执行通过。

## 依据与定位

- 需求：[spec](../../../.scratch/f407-classroom-baseline/spec.md) 的“已确认的交付与验收约定”“课前软件交付目标”“首次课堂135分钟预算”“后续赛道目标”。`resolved`只表示澄清完成；其“源码与图纸差异/已确认的软件准备缺口”是早期快照，须以本基线源码重判。
- 工作分解：[软件交付工作安排](软件交付工作安排.md)，任务03传感器、04协议控制、05面板、06交付验收。开始审计时已读任务文件01、02；03至06责任按安排表引用，不假定票据已完成。
- 项目约定：`AGENTS.md`、`docs/agents/{skills,issue-tracker,domain}.md`、`CONTEXT.md`、README当前F407段落；历史F103说明不作当前完成证据。
- 板级与构建：`Core/Inc/bsp_config.h`的F407分支、`bsp_f407.h`、`Core/F407/{main,bsp,interrupts,motor}.c`、`Makefile`；[引脚分配](引脚分配.md)、[最小构建](F407最小构建.md)、[电机迁移](F407电机驱动迁移.md)、[构建验证](F407构建验证.md)。
- 图纸：[修订3PDF](../../reference/智能三轮循迹小车_逐引脚接线图_修订3.pdf)，PDF第1页（共1页，页内无页码），2026-09-24，框2/3/4/5/6/7/8。本轮直接提取全文，并辅助查看仓库已有 `tmp/pdfs/wiring-review.png` 整页图；未把既有图像当作新PDF逐字节同一性证明。图纸是设计资料，现场条件和操作步骤不是实测或操作授权。

## Standards：规范与证据边界

| 核对项 | 基线静态证据与判断 | 最终复核要求 |
|---|---|---|
| 配置和模块边界 | F407通过`bsp_config.h`转入`bsp_f407.h`；Makefile显式编入4个F407源文件，排除旧`Core/Src`应用 | 后续驱动/控制保持配置集中，追踪实际编入路径，避免以历史源码存在证明新固件可用 |
| 资源归属 | TIM1 PWM、TIM3/4编码器、TIM6 5ms、SysTick HAL时基；IRQ集中在`interrupts.c` | 保留唯一处理器与引脚；检查调度积压、传感器超时、通信负载不破坏停止响应 |
| 停车边界 | `main`只初始化后WFI；`Motor_Stop`撤销使能，方向11/PWM0；`Error_Handler`强制停车引脚后停留 | 停车诊断入口与运动入口分别验收；软件输出、真实波形和机械停车分开 |
| 依赖与构建 | 真实ST依赖、启动文件、链接脚本和manifest在仓库；F4为默认目标 | 最终提交绑定干净构建、工具链版本、依赖哈希、产物哈希/占用；不能拿旧产物代替 |
| 测试证据 | BSP/电机主机测试运行实际项目源码、模拟HAL/MMIO；产物和vendor另有测试 | `.ci_check`仅语法/类型，缺编译器不得当通过；面板测试不得冒充真实蓝牙验证 |
| 文档一致性 | 当前F407说明明确未接入控制/传感器/面板；`移植到F407VET6.md`已说明ROM DFU无需应用DFU类 | 最终更新当前入口、协议及验证记录，保留历史说明的适用边界 |

本轴未发现必须在本轮修复的明确规范违反；此判断限于上述静态覆盖，不替代最终实现的代码审查。测试契约需随入口演进：`tests/test_f407_image.py::test_real_runtime_and_no_legacy_application` 当前要求ELF不含`Motor_Enable/SetPWM`，这是停车诊断产物的正确断言；后续运动固件不能不分目标沿用，也不能直接删除停车保证而不给替代覆盖。

## Spec：课前五项交付

| 编号/需求 | 已实现或已有证据 | 待实现/待补软件证据 | 待实物验证 | 归属 |
|---|---|---|---|---|
| P1 修订3F407工程、真实依赖、可重复交叉编译及产物，修复驱动/定时器/协议差异 | 板级/XY接口已实现；TIM资源已分离；历史真实构建与ELF/HEX/BIN/MAP记录 | 传感器与协议/控制集成；最终版本干净构建及重复性记录，固件/诊断入口与各自哈希 | 时钟、PWM、总线、引脚占用、供电、实际方向 | 03/04/06 |
| P2 控制/协议有意义主机测试，停止优先、心跳、锁存、人工重启 | BSP与电机边界测试已存在，历史记录9项通过；无完整控制/协议覆盖 | 实际控制/解析器与驱动边界测试；本表后列故障、时间边界、异常及恢复场景；执行输出 | 停止输出延迟、机械滑行、失联及异常下实际表现 | 03/04 |
| P3 Windows蓝牙控制面板及无硬件协议/模拟验证 | 基线未见Windows面板或模拟设备交付 | 连接、启停、遥控、调参、状态、日志；冻结协议；模拟互通和真实Windows交互证据 | 蓝牙配对、COM枚举、无线断连与重连 | 05 |
| P4 DFU说明、逐项测试表、参数与日志记录方式 | ROM DFU路径已有；spec已有135分钟阶段；电机文档有现场核验项目 | 可直接填写的课堂检查表、参数模板、日志格式及保存/读取办法、入口使用说明 | BOOT、USB枚举、下载校验、Flash恢复启动；逐项签录 | 06 |
| P5 分别报告主机、交叉编译、DFU、台架、实车状态 | 既有报告明确后面三项未执行 | 最终版本统一证据表，含命令、结果、失败/跳过、平台、日期和限制；单列面板模拟 | DFU/台架/实车仍待现场，不以软件完成结项替代 | 06 |

五项均不能据本基线整体标记“完整完成”；P1/P4/P5已有部分基础，P2尚缺所要求的控制/协议行为，P3待实现。

### 传感器与采样支撑

| 对象 | 基线状态 | 软件验收所需证据 | 现场证据 |
|---|---|---|---|
| 编码器 | 已初始化TIM3/4 TI12，无F407采样/速度算法 | 正负差分、16位双向回绕、左右方向配置、窗口/单位、采样积压处理测试；真实调度接入 | 手转方向、CPR和轮速标定；1320只能标暂定，不能宣称已验证rpm |
| SPI2 | 已配置Mode0、/64和两CS高，无器件事务 | 共享总线片选互斥、正常/错误/超时退出释放、初始化顺序、错误传播测试 | PB13/14/15波形、656.25kHz、两设备共存、电平 |
| MPU6500 | CS/INT配置及边沿计数，无读取校准 | 身份/初始化错误、数据解码与单位、静止校准/运动拒绝、样本有效性和日志测试；先IMU再MCP（图框8） | 静态读数、偏置、安装方向；航向辅助另行启用 |
| MCP23S17五路循迹 | CS配置，无初始化/输入采样 | 地址/寄存器配置、GPA0..4掩码、顺序/极性、其余输入上拉、忽略bit7、失败状态测试 | 五路逐路黑白、电平、顺序、高度和位置 |
| 无DET边界 | 图框3明示拔下与全白可能同为全1 | 不把bit7或全白当在位检测；读取成功不等于传感器连接正常；丢线和总线错误分别报告 | 启动前人工确认连接；断电插拔，不设计在线热拔验证 |

### 故障策略与控制/协议验收矩阵

以下场景是完成证据要求，不宣称现有测试已覆盖，也不擅自新增已确认硬件能力。

| 编号/约定 | 基线状态 | 必须补齐的软件证明 | 实物边界 |
|---|---|---|---|
| F1 上电/复位停止 | 停车路径已实现，BSP/电机有主机覆盖 | 运动入口启动/复位仍无自动使能；初始化失败与重启状态清零的测试 | 复位前后及代码执行前电平需测，外部方向上拉需核验 |
| F2 停止优先级 | 独立`Motor_Stop`存在；无运动调度/协议 | 同周期STOP与运动/启用竞争、队列中旧命令、模式切换、TX拥堵下停止；停车清目标/PID状态并撤销使能 | 收到请求至输出改变的延迟，另测机械停稳 |
| F3 全运动模式500ms心跳超时 | 未实现 | 遥控/循迹及未来运动子模式均覆盖；499/500/501ms、计时回绕、迟到心跳、坏帧/无关帧不误续期；超时在首次到期检查时停车，并说明调度延迟上界 | 蓝牙失联、电脑/面板退出；500ms不是车体停止时间 |
| F4 异常锁存/人工重启 | 电机Stop不恢复旧输出；无应用故障状态机 | 故障→停车锁存→条件恢复仍停车→明确人工重新启动；心跳恢复、重连、清错本身不得启动；故障未解除时拒绝启动 | 实际故障条件恢复后保持停止，操作者重新启动记录 |
| F5 首次丢线即停 | 未实现F407循迹 | 首个有效丢线观测触发停止，不使用旧1秒容忍；停止优先于循迹计算；首次配置关闭搜线 | 白底黑线读数/阈值及真实失线响应 |
| F6 必要传感器/共享总线异常停止运动 | BSP初始化失败进入停机；无运行期检测 | 必要样本失效、读失败、超时和过期数据不得继续闭环；共享SPI错误传播到停机，超时不得无限阻塞心跳/停止检查 | 故障注入方式须现场另行确认；不把静态全白诊断为拔下 |
| F7 IMU不参与控制时允许报错继续诊断 | 未实现 | 区分IMU器件故障与共享总线失效；诊断可继续且显式标无效数据；IMU成为控制依赖时不能沿用忽略策略 | 静态数据/校准验证先于短时航向辅助 |
| F8 限时低速搜线 | 未实现，属后续 | 默认关闭；单独启用、速度/时间有界，超时停车，受STOP/心跳/传感器故障共同约束 | 搜索距离和赛道效果另测，不能替代首次丢线即停 |
| F9 速度环/循迹环 | 旧算法不编入F407 | 控制单位、符号、限幅、积分状态、停止复位、左右差速和5ms调度测试；参数越界/坏帧不改变输出；UART分包/粘包/校验/溢出恢复与非阻塞发送 | 先双轮方向/编码器符号，再架空低速和落地调参 |

图框8另提“堵转停机”：本基线无堵转检测，现有任务04安排也未明确检测阈值。最终交付需说明其是否纳入本轮、采用何种可观测量及误报/漏报测试；若暂未实现必须列限制，不能声称限PWM或速度环已证明堵转保护。电流/温度采样并非已确认接线，不据此编造监测能力。

### Windows面板

基线以下各项均待实现或待执行证据。Windows为首个验收平台，Mac仅保留可移植性，不能列为已验证。

| 功能 | 无硬件软件验收 | 现场追加 |
|---|---|---|
| 安装与连接 | 从仓库按说明启动；端口选择、连接/断开、错误提示；模拟设备清晰标识 | 蓝牙配对、SPP/COM枚举、9600/8N1互通 |
| 启动/停止 | 明确人工启动；停止发送与界面状态正确；不可只改本地“已停”标签 | 真实遥测确认停止请求被执行 |
| 低速遥控 | 有界指令、输入释放/失焦策略、心跳与STOP；断连/重连不得重放旧运动命令 | 实际方向和低速响应 |
| 参数调整 | 单位、范围、拒绝无效值、回读/应答、运行值与默认值区分 | 标定并记录实际生效参数 |
| 状态显示 | 模式、故障、连接新鲜度、五路循迹、编码器、IMU有效性；过期数据不显示为正常实时值 | 与实物观测一致 |
| 日志保存 | 文件可读，含时间、固件/协议版本、模式/故障、参数、原始/归一化读数；失败可见 | 保存课堂数据和参数快照 |
| 模拟互通 | 面板与实际协议解析逻辑对应，双向帧样例；坏帧、延迟、断连、重连、故障锁存、心跳超时；记录Windows界面操作结果 | 模拟通过不替代蓝牙链路测试 |

### 课堂文档与135分钟记录

课前需有可填写的检查表。每项至少记录时间、固件哈希、操作/输入、预期、实测、通过/失败/未做、问题及执行者；前阶段失败先排查，不为赶时间跳过。

| 时间 | 现有依据 | 待交付的检查条目/记录 |
|---|---|---|
| 0–40分钟 | spec预算、修订3供电/接线图 | 物料/电源版本、板载占用、共地、XY参考供电和上拉、动力支路、USB与外部5V不直接并供；未知项保留现场核验 |
| 40–65分钟 | 已有ROM DFU概述 | 板级BOOT依据、数据线/枚举、选择产物及地址、下载校验、恢复Flash启动、复位停车、蓝牙状态回传；不编造跳帽顺序 |
| 65–100分钟 | 引脚表和电机待验证列表 | 五路黑白/顺序/极性、IMU数据校准、双轮方向、编码器正负与CPR记录 |
| 100–125分钟 | spec架空低速要求 | 启动、STOP、500ms失联、故障恢复不自动运行；输出停车和机械停车分别记录 |
| 125–135分钟 | spec收尾要求 | 导出参数/日志、故障和未完成项、下次计划；有条件才低速落地，不强制跑圈 |

参数记录必须含名称、单位、默认值、本次值、验证状态；方向校准、循迹极性/顺序、CPR暂定/实测、PID/基础速度、搜线及航向辅助开关应可追溯。不得让历史1320换算表掩盖尚未标定的事实。

### 后续赛道目标（不并入首次课堂通过率）

| spec目标 | 基线状态 | 课前/后续软件准备所需证据 | 最终现场证据 |
|---|---|---|---|
| 直线、S弯、左右急弯、十字 | 未实现F407策略 | 场景输入序列、速度策略、异常/停止优先测试；明确传感器几何适用范围 | 线宽、弯曲半径、安装位置/高度、场地图和日志 |
| 普通闭合线连续3圈不扶正 | 待实现且待实车 | 状态连续性、失线处置，软件测试不伪造圈数成功 | 连续3圈记录，人工干预情况 |
| 左急弯/右急弯/十字直行各10次≥9次成功 | 待实现且待实车 | 每类独立测试场景和成功定义；降低速度/识别决策可追溯 | 三组分别计数，保留失败样本，不合并成总90% |
| 十字默认直行、无路线指令T字停车 | 未实现 | 基于时序/上下文的可解释识别策略及十字/T字/宽线/全黑歧义测试；无法可靠识别时明确限制与保守处置 | 在实际几何上分别识别验证；全黑不是路口类别 |
| 达标后提速并记录最快可靠速度 | 待前述达标 | 逐级参数/日志方案，无固定速度承诺 | 已标定CPR/轮径后报告物理速度及可靠性 |

限时搜线与短时航向辅助属于单独启用的后续策略；首次保守联调不得默认依赖它们。课前若仅实现候选策略/模拟场景，应写“策略已实现、赛道未验证”，不能写赛道指标已达成。

## 执行证据台账与最终复核门槛

| 层级 | 基线已有记录 | 本轮状态 | 最终应提交 |
|---|---|---|---|
| 主机测试 | 电机迁移记录9项：1 BSP、4极性组合、3产物、1依赖；并非9项全是控制测试 | 未运行，只读测试源码 | 最终命令/工具版本/完整结果、失败与跳过说明；覆盖P2/F1–F9 |
| 真实交叉编译 | 电机记录Flash7220B、普通SRAM2536B含2KiB栈，CCM0；BIN哈希`4ede02f8c06120dd0203622aa105087268e2d6ddaee88caac845b5b53ef5e525` | 未重建、未核验当前build产物 | 最终提交、干净构建、产物哈希/占用；旧数值不可沿用作新集成结果 |
| 可重复性 | 最小构建记录39b91e2独立导出构建和同环境重复一致；电机迁移未宣称独立导出复现 | 未执行 | 当前最终源码的重复构建/依赖完整性证据与适用环境 |
| 面板模拟/Windows交互 | 无基线交付记录 | 未运行 | 独立列模拟协议测试、Windows界面实际操作、剩余链路限制 |
| DFU烧录 | 未执行 | 未执行 | 课堂记录枚举/下载/校验/恢复启动；无记录继续标待实物验证 |
| 台架 | 未执行 | 未执行 | 波形、方向、传感器、失联、停车和供电核验 |
| 实车 | 未执行 | 未执行 | 课堂低速记录与后续赛道指标分别记录 |

收到最终实现通知后，应固定新的提交或源码快照，逐项给P1–P5、F1–F9和面板/文档条目补上代码、测试、执行结果与剩余限制。先取得不与实现对话争用构建目录的安排，再执行必要验证。此时才进行最终实现的规范/需求审查；本报告不提前认可后续实现，也不要求重开已完成的01/02来承担03–06缺口。

## 阶段03复核：传感器与采样

2026-10-06，按协调通知复核已标记resolved的[03任务](../../../.scratch/f407-classroom-baseline/issues/03-sensors.md)。HEAD仍为`09e2b89`，本节审查其后工作树新增实现，前文基线结论原样保留；不将前文“待实现”解释为本阶段之后仍未写代码。阶段04正在继续，本节不审其半成品，也不作最终交付认可。

只读范围：`Core/F407/sensors.c`、`sensor_port.c`、对应两个头文件、`tests/sensors_harness.c`、`sensor_port_harness.c`、`test_sensors_host.py`及03任务；辅助读取当时的`main.c`与Makefile以确认接入边界。本轮未执行编译、测试或硬件，未读写build产物。票据报告的“2项主机测试通过、真实ARM构建Flash9472B/RAM2552B”是实现方执行记录，本审查未独立重跑或验证产物哈希。

### 审查快照

为避免同目录继续实现后误用行号，下列SHA-256标识本次读取内容；后续文件变化须重新定位。

| 文件 | SHA-256 |
|---|---|
| `Core/F407/sensors.c` | `3ABF86BD29B8F6506BB09447FF3F75808AD42C9034DCFA9F6B70811AFF958111` |
| `Core/F407/sensor_port.c` | `E97DC9080736A46A6D4D110F2BB0880A2869CC1DCBD65875799991373103CAB0` |
| `Core/Inc/sensors_f407.h` | `87DEE53B11CD99CCE944E90128500238213F519EF899DE422A136CDF83C85AE7` |
| `Core/Inc/sensor_port_f407.h` | `68C7D489A613661C7281E2D3C71C9C537438149E86E3F39C2869CE3A1D4AFE08` |
| `tests/sensors_harness.c` | `4DCDF501B5735E615EA48B9A506E45939061093A8707A6DB75A3E75B9A03665C` |
| `tests/sensor_port_harness.c` | `171AE0869529ACFFFA9FDFC3DF15A4BA0B848DF04AF3BC867370D146979EFA5B` |
| `tests/test_sensors_host.py` | `0A2D35B927DAB39AACD819D5CE675BFC6789FA76186397173015D5B94EEDE2CB` |

### Standards：静态规范结论

未发现本次范围内可确认的硬性规范违反。传感器逻辑经`SensorBus`隔离HAL，适配器使用现有BSP引脚宏；主机测试编译实际传感器/适配器源码，不是另写一份算法自测。适配器注明仅由主循环调用，片选独占依赖此串行契约，不等于存在可供ISR/多任务使用的并发锁。测试使用非交互断言及20秒运行超时；本次没有把未运行测试表述为通过。

### Spec：已覆盖内容与证据缺口

| 项目 | 可定位的实现和现有测试 | 本阶段判断 |
|---|---|---|
| 编码器双向回绕/方向 | `sensors.c:2–12`按16位模差转换有符号差分，左右独立sign；`sensors_harness.c:18–22`验证两次跨界及右侧反向 | 实现与示例测试成立；输出是两次调用间counts，接口本身不保证10ms，且要求采样间真实位移绝对值小于32768以避免回绕歧义 |
| SPI片选及HAL错误释放 | `sensor_port.c::transfer`先拉高两CS，再选一个，HAL返回后释放；适配器harness对两设备和4种HAL状态检查互斥、结果及释放 | 有实际边界测试。2ms是传给HAL的超时参数，不是主机已证明的墙钟上界；测试也未断言所选低CS必定匹配device、SPI句柄和传输内容，终验宜补精确路由断言 |
| MCP初始化/无DET | `sensors.c:32–55`全端口输入、上拉、极性寄存器、配置回读、低5位取反；测试中心/左端/全白、读失败及上拉配置不符 | 已实现黑低和顺序固定的基础读取，bit7不用于在位检测；仅测试mask=0不能证明能够区分拔下/全白，代码也未作该区分 |
| IMU识别/校准 | `sensors.c:58–110`身份检查、复位/配置回读、14字节大端解码、200个新样本均值及运动阈值；测试正确/错误ID、+1g/+131原始陀螺值和超阈值拒绝 | 基础逻辑可定位；“静止”是阈值判据，不是物理静止证明。低于阈值的持续转动仍可能被吸收为偏置，现场需静置 |
| 10ms接入 | 当时`main.c`以`HAL_GetTick`间隔>=10调用采样，Makefile确实编入两个新源文件 | 接入存在；未有调度/延迟的主机证明。长SPI事务或积压会延长counts实际窗口；不能直接把任何差分都当固定10ms速度 |

**03-R1，测试覆盖缺口：IMU数据有效性与错误路径尚无行为测试。** 03验收要求“原始数据与静止校准”“错误路径主机测试”。`tests/sensors_harness.c:33–34`仅对Track注入失败；`:36–45`的IMU全部读取成功且ready一直为1，只含正值数据。适配器测试能证明HAL错误时释放CS，不能证明上层在状态读取失败、14字节读取失败、无新样本、配置读回不符时的状态正确。需补可选择事务的失败注入，断言返回值、`fresh`、校准样本数及bias不被无效数据推进；补负数/边界值、各轴及温度字段解码，199/200新样本边界，以及加速度运动拒绝。此项是实际覆盖不足，不声称已观测到运行故障。

**03-R2，测试覆盖缺口：MCP模拟器不足以证明初始化恢复及逐路输入契约。** `tests/sensors_harness.c:3–15`把器件模拟成无条件线性数组，写什么即可读回什么，不模拟BANK/SEQOP行为；因此`:25–26`不能证明`sensors.c:33–35`宣称的MCU单独重启后BANK恢复。现有输入仅中心/左端/全白，未单独扰动高3位，也未测试右端/多位或初始化中途读写失败。需针对声明的恢复路径提供寄存器映射模拟或明确事务序列断言，再补逐路、忽略高位、初始化失败/读回不符场景；不必穷举所有寄存器或镜像整个实现。此项同样是证据缺口，不据简化模拟器推断真实芯片必然失败。

### 留给04/06集成复核的具体点

- `Imu_Read`返回true也可能`fresh=false`（`sensors.c:85–88`）；总线错误会返回false，但已有bias/校准计数仍保留。调用方须区分“事务成功但无新数据”“有效新样本”“总线失败”，规定校准中断/超时策略，记录样本年龄；不得用旧样本或旧成功状态刷新传感器健康。此处列接口契约，不因04尚未完成认定其有缺陷。
- HAL适配器只返回bool，不能单靠这个值区分IMU器件问题和共享SPI故障。终验需异常注入贯通传感器返回值→故障分类→控制停车/诊断状态：IMU未参与控制时可以继续诊断，但共享总线异常不能被归入可忽略IMU错误。
- 当时诊断`main.c`丢弃初始化和读结果，且不调用`Imu_Calibrate`，仍无电机使能路径。这不使停车诊断基线自动变成危险运动固件，但03公开API完成不能表述为已经交付校准操作、故障遥测或控制保护；04/05/06须落实这些入口。
- 10ms采样应在调度测试中覆盖正常周期、延迟/积压、计时回绕；固定窗口控制必须限制或识别超期样本。CPR、rpm和线速度继续标待标定。
- 循迹极性/通道顺序当前硬编码为黑低、bit0最左；现场若不符，需有明确校准/配置办法。MCP回读用于检查配置/部分通信异常，不是传感器存在性或共享总线任意故障的完备检测。
- 静止校准、传感器实际应答、片选电气时序、两设备共享总线、编码器实物方向/CPR均未上板验证；不以2项主机通过或9472B构建记录替代。

阶段结论：Standards无已确认硬性违反；Spec有2项具体测试覆盖缺口（03-R1、03-R2），外加上述集成复核点。本次未确认必须直接修改生产源码的功能故障，也未独立验证票据中的测试/编译执行结果。保持03现有票据不变，由实现方补证据并在终验时复核。

## 阶段04复核：控制、协议与真实主循环接入

2026-10-06，按协调通知读取已resolved的[04任务](../../../.scratch/f407-classroom-baseline/issues/04-control-protocol.md)。基线仍为`09e2b89`，审查对象为其后未提交的工作树快照。只追加本节，不改变前文历史结论、不修改固件/测试/票据，不执行构建或测试。05面板尚在开发，本节不审其完成情况。04票据报告的主机测试及两套ARM构建成功仍是实现方记录，不是独立执行结果。

### 本次快照

读取范围包括control/runtime/uart/main/interrupts、对应头文件、app_config、sensors/sensor_port及头文件、控制/协议/UART/传感器测试、产物测试与Makefile。关键文件SHA-256如下；本节行号对应此快照。

| 文件 | SHA-256 |
|---|---|
| `Core/F407/control.c` | `97E1FDAD32030A17C333A6C1BBCD9F8615B58FC0C3571F07DF099629687C6CC2` |
| `Core/F407/runtime.c` | `8D45F7492E1E2B133A0D8D8272CC80E242A836B9F50ED33F5E71E7974D375620` |
| `Core/F407/uart.c` | `EB8FD808AA86E2A16AC394CB06121912187DDFF6655ADD790B1D4D353A5F58D9` |
| `Core/F407/main.c` | `8F79D824044292DDBB9E22C287CF4F72456831EA78E89A6B2C243A41567E5601` |
| `Core/F407/interrupts.c` | `164F67128C140B3EB95EB33DA597781887A640CFD2754DAA05B1271579B31A57` |
| `Core/F407/sensors.c` | `6D637CF0104D36536C1E1FCB80264010E7B1300D74FBD75943141A197078A62D` |
| `Core/F407/sensor_port.c` | `9CD4E2B75E69094F1D50672A402BD76248261CCE44C06AF372ACEA35089409C3` |
| `Core/Inc/control_f407.h` | `0F40074BFEB9C402E842C69EC66A8C0077BDC6E794B0D8807C2BB15C63D4E117` |
| `Core/Inc/runtime_f407.h` | `3E8714864D819025B67F85371980A347D048BA416E4889344A08FC3E28903626` |
| `Core/Inc/uart_f407.h` | `8DC3A58FA13D4B9CE1494A43C422705B374E3F98DB3BD3C9D1B6EDF184FBE008` |
| `Core/Inc/app_config_f407.h` | `929B86D3C4555FA9E95FE70E3674DFD5CF36563CB767B0BD65C0243138290726` |
| `tests/control_harness.c` | `F3515EF6D2A8A05AFD02EE37C5F2A7993B183B4A4FA6379B2A740F4409DB42C9` |
| `tests/protocol_harness.c` | `88966D0787CAF20B7697D5FF818AA2D673C81EC3B4E2762F1B9A48B495821A2C` |
| `tests/uart_harness.c` | `2E2E7BD603D9779CEDDA29469F15314E169274BBEEEB2D211FCA1E2EEE4065B5` |
| `tests/sensors_harness.c` | `E3256792938D8E3C4CDCC172D2E02C1D7C36164367AE18E7A6F93C616290696C` |
| `tests/sensor_port_harness.c` | `13A67405983903A1023BEC0C5A0427597BB6F639E0A0ABB6576C18B789A5A1F6` |
| `tests/test_sensors_host.py` | `612C10796439E0919AFE5A2ED8556FBF9618EB4A6E0FC8863488AAD453D8B2FD` |
| `tests/test_f407_image.py` | `004C1BCF19F5EB10B6B3E175D8B3F37B66AA08DD35C5886EC69E4F3217531889` |
| `Makefile` | `F58519A71B0C2C17E4AEA82B4BA02D877E11EB4EEDAF9CE3E84FCC04625AB05E` |

### 03-R1/R2补充复查

- **03-R1：所列主要分支已有测试源码，待最终执行记录确认关闭。** 新harness在199样本处注入无ready、0x3a失败、0x3b失败，确认`fresh=false`且样本数不增，然后第200样本完成；另含加速度/陀螺运动拒绝、三轴负值/有符号边界及温度、配置读回不符和写失败。不是本轮独立通过声明。
- **03-R2：所列主要覆盖已有测试源码，待最终执行记录确认关闭。** 模拟器新增BANK1退出首事务断言，初始化失败与读回损坏；逐路bit0–4、改变高3位而结果不变、多位及右侧偏差。该BANK测试是明确序列契约，并非完整芯片仿真，符合前次建议的有限补证方式。
- 适配器测试新增设备对应CS、hspi2句柄、长度和输入断言。新增`SensorPort_TakeError`累计错误标志尚无取出/清除行为断言，留给集成补测。
- 编码器增加`Encoder_Poll`：不足10ms不采样，10–20ms差分归一到counts/10ms，超过20ms标无效；harness覆盖跨时钟回绕、10ms、15ms、30ms。现场方向/CPR和物理采样时序仍未验证。

### Standards

保持BSP宏、实际源码测试、固定依赖、独立运动/诊断输出目录和真实编译路径，未发现本次范围中新的明确配置/依赖规范违反。主要规范证据缺口是04-R3：主机行为测试尚未执行真实应用编排，不能把各模块测试组合起来表述为应用集成已验证。不是风格或代码异味推断。

### Spec：可确认问题

**04-R1 [P1] 停止屏障在下一轮主循环无条件撤销，跨批次旧启动帧可以恢复运动。**

证据：`control.c:7`清`stop_barrier`，`main.c:28`每轮调用`Runtime_BeginBatch`；`runtime.c:18–19`没有检查上一批部分帧或停止发生时间，`:28–30`只限制帧年龄<=100ms；`main.c:32`以本轮最多256字节划批，而非协议会话/人工动作划批。`Control_Start`成功会清目标再进入运行，循迹模式之后自行产生非零目标。

静态可复现序列：心跳和传感器有效；在一轮解出STOP，再消费一个已排队START_TRACK帧的前若干字节；下一轮BeginBatch清屏障，继续输入该帧余字节（帧原始接收时间仍早于STOP处理时间且年龄<100ms），START会通过，10ms后在有效线路上重新输出PWM。同样，清错后跨轮完成的旧启动帧不被区别为“人工重新启动”。该序列是代码推演，本轮未运行；实际是否发生依赖串口分包/排队及主循环切分，不能用同一批内STOP测试排除。

现有`protocol_harness`把STOP与START整帧放在同一批验证拒绝，然后显式BeginBatch后验证可启动，未覆盖上述原始时间不变的分包。建议记录停止/清错的命令失效边界（时间、接收序号或重新武装会话），拒绝边界前已经进入接收/解析队列的运动请求；仅靠每轮重置bool不足。回归应覆盖整帧、半帧、排队、跨256字节边界，保留新的明确人工启动途径。

**04-R2 [P2] IMU首次有效样本前即可上报“数据有效”的零值。**

证据：`main.c:20`以`Imu_Init`的配置成功结果直接设置`runtime.imu_valid`；`:25`把`imu_ms`设为初始化后的当前时间。在第一次有效14字节样本之前，`Imu`字段仍是初始化的0；无ready返回true不会清除此标志，直到`:51–53`超过100ms才失效。`runtime.c:77–82`把该标志和accel/gyro数值一并遥测。Runtime在IMU的100ms+50ms初始化等待之前设定遥测起点，因此主循环第一次即可满足100ms发送条件，发出“有效”的全零读数；这不需要故障或运动。

应将器件初始化成功与至少取得一帧有效数据分开，初始`imu_valid=false`，由成功的新样本建立有效性并维护年龄。加上初始化成功但ready始终0、首个新样本、样本过期三段测试。该问题影响诊断/校准入口的可信状态，不据此宣称基础循迹已使用错误IMU数据（目前其未参与控制）。

**04-R3 [P2，验证缺口] 尚无主机测试执行真实应用编排，初始化、故障传播和时间边界的接入未被验证。**

证据：`test_control_host.py`只编译control与harness，`test_protocol_host.py`只编译control/runtime与harness；`test_sensors_host.py`分别编译传感器、适配器和包含uart.c的harness。所有这些测试均未执行`main.c`主循环或`interrupts.c`实际串口处理器；产物测试只检查符号/向量，不能补足运行行为。因而“499/500/501ms通过”确为控制API时间边界，“UART溢出通过”确为队列局部行为，二者均不是从ISR收字节到真实Motor调用的端到端验证。

需提供可运行的一轮应用调度边界或等价真实代码harness，至少验证：首次传感器数据前禁止运动；04-R1的分包停止；SPI错误标志到FAULT_SENSOR和Motor_Stop；校准100ms无新样本中止；编码器采样超期；UART错误清RX同时丢部分帧；TX满时停车继续执行；两个编译模式实际输出调用。测试不应另写一份主循环模型代替被交付代码。阶段05无需为此停工，但04不能仅凭模块通过就关闭应用集成证据缺口。

### 其余重点项的静态结论与边界

| 核对项 | 结论及证据 | 后续复核 |
|---|---|---|
| 499/500/501ms、时钟回绕、全部运动模式 | `Control_CheckTime`对非STOP统一检查无符号差>=500；control_harness循环MODE_TRACK/RC及499–501跨回绕。dispatch在接受迟到心跳之前先按处理时刻检查，避免迟到心跳直接恢复超时模式 | 已有API级测试源码；需04-R3检查真实采样/串口负载下输出停止时刻，500ms不是机械停稳时间 |
| 故障锁存/清除 | `Control_Fault`置位并Stop；`Control_Clear`要求停止、有效且新鲜传感器、有效心跳，清错仍Stop；新心跳本身不清故障 | 原则正确；人工重启的新旧请求区分见04-R1 |
| UART RX溢出与错误 | `Uart_TakeError`关中断读取/清标志并清RX；main同时清解析部分帧和置FAULT_UART；harness有满256字节后溢出与错误标志 | 未模拟main取错后、处理本轮期间ISR又报错的交错；须证明下一次输出决策与锁存的边界，不把禁中断模拟空宏当并发实测 |
| TX满/回绕 | `Uart_Send`整帧容量不足返回false，不阻塞；emit统计dropped_tx；harness覆盖TX计数回绕、满队列拒绝 | 协议harness的send恒true，未断言发送拒绝时STOP/故障仍生效及丢帧计数；运行链路见04-R3 |
| 共享SPI错误 | HAL非OK设置bus_error；main初始化后和每轮采样后取错，运行期转为传感器无效并锁存停车。IMU身份/配置不符但HAL无错误时可继续其他诊断；无ready超100ms只标IMU无效，不等价总线错误 | 代码路径可定位；新增累计错误标志及应用Motor输出尚无主机贯通测试。不能声称可以检测任意电气故障 |
| 校准超时 | main对读失败立即终止校准，距最后新样本>100ms终止；START被calibrating/requested阻挡 | 这是样本间隔超时，没有独立总耗时上限；低频但每次<100ms的新样本会延长200样本校准。需明确文档期望，不直接判为违反已确认固定总时限 |
| 编码器时间/首次状态 | `Encoder_InitTimed`初始valid=true，首次5ms Poll返回false时仍可上报零速度有效；首个完整窗口10ms后才得到实际差分。>=10且<=20ms按实测间隔归一，>20ms无效 | 第一完整窗口前是否允许标有效须明确，首次控制输出路径需04-R3证明不依赖虚构速度；本次未据此另列必现电机故障 |
| 诊断目标 | Makefile默认运动目标`build/F4`，DIAGNOSTIC=1为`build/F4-diagnostic`；main预处理分支仅Stop，无Enable/SetPWM；产物测试已分目标查符号 | 静态支持“诊断不调用运动接口”；未本轮检查实际ELF或重建，不能声称独立产物验证通过。诊断仍可在协议层先应答START成功后同轮强制STOP，文档/应答语义应明确 |
| 无DET、线路歧义 | Track仍只低5位，不声称检测J_LINE在位；Control仅接受连续1/2位窄线，零mask即停，宽/分裂mask故障停车 | 符合首次保守联调；十字直行/T字识别尚未由此实现，保持后续目标，不作为04回归 |

本阶段结论：2项可确认行为问题（04-R1、04-R2），1项应用集成验证缺口（04-R3）。03-R1/R2主要补测已见源码，尚待执行证据闭环。本轮只读推演和追加报告，未运行测试/构建、未修改实现、未操作硬件；最终审查须复核修复后的新快照。

## 2026-10-07修复复核：03补测、04-R1/R2/R3与面板协议

本节延续上次发现，不重做基线审计。HEAD仍为`09e2b89`，针对最新工作树；04票据当前已重开为claimed，05也为claimed。只读取源码/测试并追加本报告，未执行构建、测试、浏览器操作或硬件。协调通知报告修复后的两模式App及C模拟互通测试通过；这是转述的执行证据，最终仍需对应快照、完整命令结果与产物哈希。

### 快照与关闭判断

| 文件 | SHA-256 |
|---|---|
| `Core/F407/app.c` | `8AA7703560B2AC4F4601E1A4649F93F285618D89D68CA47D5DC88011E68D02D8` |
| `Core/F407/runtime.c` | `2F0277F10084FA5BC73841B202EA48F86991995A9BCC5B4122B5F78B4C5295C6` |
| `Core/F407/main.c` | `B75E07BFBACA926C0028209513384305E264C46FAE0DBF650A55B3FC424D704D` |
| `Core/F407/sensors.c` | `4021F7C22A7E5235AB4833CD54A66612D9856309477C1968A5AA0E58D89878E5` |
| `tests/app_harness.c` | `2925CA23B66EF9D7172720F428F45052BD806A0BABBE5B2F76990B3BBE086844` |
| `tests/test_app_host.py` | `CC089986FEDB47B9F9B897C0C61060734495C7A70E2C97C42B67F9C84E75507D` |
| `tests/protocol_harness.c` | `D5A013376787CC2925352A5EF78D923C033DF849F4839FEFA74382681BA80C24` |
| `tests/sensors_harness.c` | `E3256792938D8E3C4CDCC172D2E02C1D7C36164367AE18E7A6F93C616290696C` |
| `panel/device.py` | `7A1C0902E873E60587331B62A11BF888453E421EB4603552249317551F4D5041` |
| `panel/server.py` | `B7FFD955853A415B7D2441BA2B05C091678D0B184BB833D324C748510A09387D` |
| `panel/index.html` | `0A96582D59B11303FF4B8A7A92F3A98947836C27DDAB90F6ED537AABB2A2D9E6` |
| `panel/simulator.c` | `6D75F08294B0F8155EB4B97100F3AD036306A1CC5D87830F0FB08A5DA09D57AD` |
| `tests/test_panel.py` | `DC364B1C1475B0425443A1020BB32FA47A303FB61D824E76F772E5513C1D591A` |
| `Makefile` | `6C87882274ECE0C8BA612803DB8F1F3CBDB88C927EF7FCD000F60E10B7E57507` |

| 发现 | 当前判断 | 精确关闭依据/剩余证据 |
|---|---|---|
| 03-R1 | 测试源码缺口已补；执行证据待最终归档 | `sensors_harness`与上轮补充快照一致，含199/200、新鲜度、分段读失败、写/回读失败、三轴负值边界、温度、运动拒绝；不再重复列为缺少这些测试 |
| 03-R2 | 测试源码缺口已补；执行证据待最终归档 | BANK恢复序列、逐路/高位忽略、多位、初始化失败均保留。该序列模拟不等价硬件BANK实测 |
| 04-R1 | 原行为缺陷在当前源码中已修复 | `Runtime_InvalidateMotion`保存跨轮时间边界；STOP和成功CLEAR都调用，START要求首字节接收时间严格晚于边界，并以半量程无符号比较兼容回绕；BeginBatch不会清边界。App对运动→停止/故障变化同步失效旧命令。`protocol_harness`测试旧时间戳分包拒绝及新启动接受；`app_harness`经真实USART IRQ送入STOP+半个START，下一轮续帧仍停 |
| 04-R2 | 原行为缺陷在当前源码中已修复 | `App_Init`设置`imu_valid=false`，`App_Step`仅在`Imu_Read`成功且fresh时置true；无样本超100ms及错误清valid。App测试断言初始化后无有效IMU、首次新样本后有效。编码器也改为初始valid=false，完整窗口前保持`sensors_valid=false`且不虚构故障 |
| 04-R3 | “没有真实应用编排测试”的结构性缺口已关闭；场景覆盖尚有下列保留项 | `main`真实调用`App_Init/App_Step`；`test_app_host.py`编译实际bsp/motor/sensors/sensor_port/control/runtime/app/interrupts，UART源码由harness直接包含，`bsp_harness`在TEST_APP调用测试。两种APP_DIAGNOSTIC宏分别运行；输入经USART寄存器及真实ISR→UART→解析→App→实际电机驱动→模拟CCR，不是复制主循环 |

上述“已修复/已补”是独立静态复核结论，不是本轮独立测试通过。最终执行记录应绑定修复后版本；未再发现原04-R1/R2序列仍可绕过的明确路径。

### App贯通测试：已覆盖与终验保留

新App测试已检查：首次完整传感器样本前启动不产生PWM；IMU新鲜度；遥控产生实际模拟CCR输出；跨轮旧启动帧拒绝；SPI超时到传感器故障和停车；恢复/清错仍停；校准无新样本超时失败；USART ORE清部分解析帧并停车；30ms采样超期无效；TX满时遥测丢弃计数增长；诊断模式不产生PWM。源码另外在输出前再取一次UART错误，覆盖了上轮指出的轮内新错误处理位置。

仍不能把以下未覆盖场景写成“已由App贯通测试验证”：

- 499/500/501ms及计时回绕目前仍由control_harness验证；App测试没有在两种运动模式下推进到这些边界并断言CCR停车。应在终验补一条真实App的失联路径，避免API通过替代实际调度。
- App的30ms超期和TX满测试发生在此前UART故障已经停车之后；它们能证明状态/计数，不证明“正在运动时超期或TX满后收到STOP”能停车。将这两个场景从明确已运动的前置条件开始，分别注入后断言CCR0，证据会更准确。
- 分包STOP已贯通；清错后的旧START、时间边界回绕、长队列切分没有等价App断言。修复逻辑静态成立，终验至少补清错旧启动或明确复用的协议层回归，不能把“人工重启全部场景”写成穷尽通过。
- 当前harness仍把中断屏障/关中断宏设为空并模拟MMIO，不能证明真实中断竞态、电气时序、2ms HAL墙钟超时或机械停车。上述边界继续保留。

这些是终验保留的覆盖点，不将已有结构性修复重新描述为“无App测试”。

### 面板协议静态一致性

| 项目 | 当前源码核对 |
|---|---|
| 帧格式 | Python `frame`与C `Protocol_Frame`均为AA55、cmd、len、payload、cmd+len+payload模256；上限48；已有STOP字面量测试 |
| 命令 | mode/drive/param/calibrate/heartbeat/clear/get-params分别映射1/2/3/4/6/7/8；drive双小端int16，param为id+小端int16；范围与固件一致 |
| 遥测 | 固件0x81长42、偏移6处14个int16、34处uint32时刻、38/40计数，与Python解包一致；0x82双字节ACK、0x84六参数一致；版本不兼容报错断开 |
| 连接/重连 | Session连接先STOP和参数请求，无自动START；心跳由页面活动状态发送；断开请求STOP。静态未见重连恢复旧运动指令逻辑 |
| 数据边界 | 面板明确counts/10ms及raw IMU，不把CPR暂定值换算rpm；显示数据过期、IMU有效位、SIM标识与无DET限制 |
| 模拟器真实性 | 构建脚本直接链接固件control/runtime，确实复用C解析与控制；传感器为理想数据，校准被直接置完成，不执行App/SPI/UART/IMU算法。因此互通可作协议证据，不能作硬件或校准算法验证 |
| 浏览器状态 | 本轮未打开或操作面板。实际Windows浏览器验证正在由实现方完成，不能由HTML静态检查推断按钮、焦点停车、日志下载实际通过 |

未发现上述帧布局/命令号/遥测偏移的明确不一致。当前`test_panel.py`含C模拟互通、心跳超时、重连STOP及日志文件存在检查；它不验证全部界面交互、日志内容完整性或真实SPP链路。

**05-I1：最终测试入口存在可确认的依赖缺口，须在06交付前补齐。** 当前Makefile的`test`只构建两种ARM固件，然后运行unittest发现；`tests/test_panel.py`在连接SIM时直接加载`build/host/smartcar_sim.dll`（非Windows为.so），测试setup和Makefile均未调用`tools/build_simulator.py`。从没有既存host模拟库的干净源码目录运行`make test`，会在加载库时失败；若已有旧库，则可能测试了与当前control/runtime不同的过期模拟器。这是静态依赖结论，本轮未执行复现。应把模拟器构建纳入明确的测试准备入口/依赖，最终在独立干净目录验证，并保留执行命令。05正在开发，此项作为交付集成缺口，不称为已完成面板的回归。

本轮结论：03-R1/R2补测、04-R1/R2修复与04-R3结构性补测均有静态关闭依据；应用场景仍有上述终验保留，另有05-I1测试依赖待补。未发现新的明确固件运行缺陷。最终完成还需软件交付记录、干净构建及哈希、测试完整结果、Windows实际交互记录；DFU、台架和实车继续单列未验证。

### 同轮交付前快照复查补记

实现方在本节写入期间继续更新。交付前重新读取确认：Makefile现已在unittest之前调用`$(PYTHON) tools/build_simulator.py`，SHA-256为`E3360F3AFF49841180455DF2495D4354541A0D47140086033E37839130CE0907`。因此**05-I1的构建依赖缺口已在新源码中关闭**，上段仅保留为早先快照发现；仍需最终干净构建执行证明。`app.c`同期仅整理了所读App_Step缩进，复读逻辑与上述关闭判断一致，新哈希`29BDEC697C52E7C9DD1E0AF681EE9F12FDAC95F77427758820030A163C951C9A`；runtime与app_harness哈希未变。本轮最终状态以此补记为准。

## 最终交付覆盖审计：81f56c3

日期：2026-10-07。固定提交`81f56c3e65d3434612593490843349a4610ac738`，相对基线`09e2b89740f03e6554c4e4a2821ef1f5b45bd3c4`。读取时HEAD吻合，Core/tests/panel/Makefile/docs相对该提交无已跟踪内容差异；本文为单独未跟踪审计文档。只追加报告，不构建、不运行测试、不修改实现、不操作硬件。本节是此前阶段审计的收口，前文保持历史状态，最终判断以本节为准。

**结论：固件、自动软件测试及交付材料已有证据支持；Windows实际界面验收仍缺失，P3不能全部关闭，05/06不应标记完全验收。** 本次未发现新的明确固件正确性问题。DFU、真实蓝牙、台架与实车均未执行，与软件缺项分开列示。

### Standards：最终规范与记录核对

固定提交包含分层实现、真实HAL/CMSIS、两种固件入口及独立构建目录；主机测试运行实际应用/驱动源码并明确模拟外设边界。README更新当前入口，旧F103段落标为历史；`F407最小构建.md`首段也明确下文为01/02历史记录，避免将原停车最小目标误作当前默认目标。当前协议、引脚、课堂表和面板说明对未验证状态的描述一致。未发现新的硬性规范违反或需要要求修改的代码异味。

读取[软件交付验证](软件交付验证.md)、`build/verification.log`末段与`build/rebuild-before.json`。日志列出21个测试条目均为ok，汇总`Ran 21 tests in 16.334s / OK`，含两种App、四项面板模拟及诊断产物测试；本轮是核阅已有执行结果，不是独立重跑。首次历史App_Init断言失败及修正后的复跑在交付文档中已如实记录；当前产物测试检查App_Step并排除旧Core/Src路径，未简单用同名App_Init排除新应用。

两目标8个产物同工具链同路径重建一致，依据交付记录、重建前清单及协调方已核验结果；本轮另独立只读计算两个当前BIN哈希，均与记录相符：

- 运动：`bea52ea537a5c353bee9f460075d79f030214ac3b038b700668e452160e2171e`。
- 诊断：`987ca14f828a58fc0f2a65996b749ade5dfeb480d07cffb27121b79105805182`。

本次未重新比较其余6个文件，也未宣称从全新导出目录独立重建。执行日志和重建清单位于被忽略的build目录，最终交接应保留它们；仅克隆提交无法取得这些原始运行日志。源代码提交和文档记录仍可追溯，但“同路径重建一致”不等于跨机复现。

### 历史发现收口与补测证据

| 编号 | 最终判断 | 依据 |
|---|---|---|
| 03-R1 | 关闭原测试覆盖缺口 | sensors_harness保留199/200样本、无ready、分段读失败、初始化失败、运动拒绝、负值/温度边界；全量日志中`test_public_sensor_contract`通过 |
| 03-R2 | 关闭原测试覆盖缺口 | BANK恢复序列、逐路和高位忽略、多位输入及初始化读写/读回错误测试保留；同一传感器测试通过；不扩大为芯片实测 |
| 04-R1 | 关闭已确认行为缺陷 | runtime持续保存STOP/CLEAR边界并拒绝旧时间戳START，App同步故障/停车边界；protocol及实际App分包STOP测试均在最终21项通过记录内 |
| 04-R2 | 关闭已确认行为缺陷 | 首次IMU新样本前无效、首次完整编码器窗口前不准运动；App实际链路测试通过 |
| 04-R3 | 关闭“缺少真实App测试”的原缺口 | 两种APP_DIAGNOSTIC编译模式贯通实际ISR/队列/协议/App/驱动；本轮确认补入运动中失联及TX满STOP场景，详见下段。仍保留未覆盖场景边界，不声称穷尽验证 |
| 05-I1 | 关闭构建依赖缺口 | Makefile先构建C模拟库再发现测试；verification.log明确列出`python tools/build_simulator.py`及其DLL路径，之后4项面板测试通过 |

`tests/app_harness.c`的新增非诊断分支循环运动模式1/2，各自从新心跳开始推进到495ms，再4ms断言年龄499、模式仍运行且CCR1>0；再1ms断言双CCR0及FAULT_HEARTBEAT，501ms再次停车。因运行采用零编码器反馈，该测试证明的是模拟时间中的输出和状态契约，不是机械运动。随后重新启动遥控、断言CCR1>0、填满TX、发送STOP、断言双CCR0且dropped_tx增加；通过实际TX IRQ释放队列。因此上轮“运动中超时/TX满”的两项缺证已实质补齐，不再保留为未补。

仍保留的**非阻断覆盖限制**：App里的30ms采样超期测试仍在已有UART故障停车后运行；运动中超期只有Control层测试及App静态路径支持，没有专门从运动状态开始的App断言。时间回绕在Control/Encoder层测试，STOP边界回绕、清错后的旧半帧START及长队列切分未各自做App回归。这些不构成本轮新确认的功能缺陷，也不推翻已关闭的原发现，但报告不得称所有调度/并发/恢复组合已验证。

### Spec：P1–P5最终对应

| 要求 | 最终交付及证据 | 判定/剩余项 |
|---|---|---|
| P1 修订3F407、依赖、构建与产物 | Makefile、Core/F407、固定71文件依赖、两目标4类产物、真实构建/产物测试、哈希与重建记录 | 软件交付有证据支持；本轮未独立重建。引脚/时序/电气及实板启动待现场 |
| P2 控制/协议有意义测试 | control/protocol/sensors/UART/App/motor测试及21项通过日志；包含停止、心跳、故障恢复、分包和输出边界 | 自动软件验证有证据支持，原03/04发现关闭；保留上段覆盖限制，不宣称机械停车或硬件并发验证 |
| P3 Windows面板及无硬件模拟 | panel、同源C模拟器、4项Session互通/解帧/参数/故障/日志测试及使用说明 | 实现与自动协议模拟完成；**Windows真实界面仍未验，不能完整关闭**。真实SPP/COM链路另待实物 |
| P4 DFU、逐项现场表、参数/日志 | `课堂135分钟检查表.md`含阶段预算、操作/预期/实测/责任人栏、固件哈希、ROM DFU流程及参数模板；面板说明含JSONL和参数JSON办法 | 文档交付覆盖要求，现场空栏符合未操作事实；板级BOOT细节待资料/现场，不编造步骤 |
| P5 分层报告 | `软件交付验证.md`分别记录主机、交叉编译、面板模拟、Windows UI、DFU/台架/实车；失败/重跑及局限明确 | 报告覆盖要求；不能把前两类通过转写为后三类通过 |

### 文档与实现的一致性

协议文档的48字节载荷、42字节遥测及各偏移、六项RAM参数、100ms帧时间、500ms心跳、诊断拒绝运动与源码一致；PWM明确是控制器请求值，驱动仍把绝对值<50归零，避免把遥测值误认作物理占空比。校准200个新样本、>100ms无新样本中止、没有固定总耗时上限均已写明。CPR未确认、无DET、IMU未参与基础控制、共享总线错误停车、MCP初始化失败需复位等限制有说明。

课堂表提供诊断BIN到运动BIN的分阶段路径，ROM DFU不依赖应用USB类或ST-Link，USB与外部5V不直接并供，软件输出与机械停车分开计时。此处核对的是资料和实现的内在一致性，本轮未重新在线核验ST资料，也未执行DFU。

后续十字直行/T字识别、限时搜线和航向辅助仍未实现；当前只有窄线控制和歧义停车，文档明确候选策略及需验证场景，未冒充十字/T字分类。3圈、左右急弯/十字各10次≥9次目标继续保留为后续实车验收，不能用本次软件完成状态关闭。

### 仍需完成的验收项

1. **Windows UI实际验收（当前唯一明确未闭环的课前功能验收项）**：按面板说明1–6实操连接、启停、按住/松开遥控、切出/隐藏页面、停心跳、故障恢复/清错、重连、参数回读、快照下载与日志可读性；记录Windows/浏览器版本、操作者和结果。既有工具尝试失败不是通过，静态HTML/JS和Session自动测试均不能替代。
2. **最终记录归档**：将本固定提交、双目标产物哈希、21项测试及重建日志作为同一交付包保留；05/06在UI验收前保持未完全验收，完成后补入真实结果。本文不代改票据状态。
3. **现场与后续目标**：实际蓝牙、DFU、板级占用/BOOT、电源/电平、编码器方向/CPR、传感器顺序/高度、PWM时序、机械停车及赛道均待实物验证；不妨碍如实交付现有软件，但不允许宣称整车已调好。

最终独立判断：此前已确认的03/04问题与05-I1已有关闭证据；没有新增已确认生产代码缺陷。P1/P2/P4/P5有交付证据，P3仍受Windows实际UI未验限制。可交付当前软件和材料，不能宣称课前五项全部验收完成。本轮仅追加独立报告，未争用构建、未推送、未烧录或运行电机。

## 4c90a5b最后证据核对

2026-10-07。HEAD核实为`4c90a5b5b4de1b50be6ed2b4b9ab437317c5d028`。本轮读取该提交源码与最新工作树`软件交付验证.md`；读取时后者及06票据有未提交补充，源码/测试没有相对HEAD的已跟踪差异。因此独立导出验证的新增叙述属于提交后的记录，不将其误说成4c90a5b自身已包含的文档内容。本轮只读日志、源码及产物哈希，未运行构建/测试，仅追加本节。

### 可关闭的证据项

| 核对对象 | 实际查见证据 | 结论 |
|---|---|---|
| 最终22项自动测试 | `build/verification.log`汇总22项、17.454s、OK；`build/source-verification.log`逐项列22个ok，汇总24.529s、OK | 有记录支持。准确称“22项自动软件验证”，其中含主机行为、4项产物及依赖检查，不应全部说成22项控制行为测试 |
| 两配置真实交叉构建 | 导出构建日志第28/67行分别链接F4/F4-diagnostic，使用arm-none-eabi-gcc、真实HAL对象和F407链接脚本；第30/31及69/70行给出12648/12216B Flash、均4360B普通RAM | 有实际编译/链接记录支持；不是HAL桩语法检查，也不是本轮重新执行 |
| 已提交源码独立构建 | 最新记录指明git archive导出4c90a5b至`build/source-4c90a5b`；该目录独立构建日志含双目标、模拟库现编和22项测试通过。提交树在根build及未跟踪vendor目录下无内容 | 支持“该提交导出后不依赖原工作目录build或未跟踪vendor即可构建/测试”的记录结论；导出仍含仓库已跟踪历史tmp资料，不将其误表述为完全无历史临时文件 |
| 导出与主目录固件一致 | 本轮独立读取并比较两个目录的运动/诊断BIN及HEX，4对SHA-256全部相等 | 支持两目标BIN/HEX一致；不扩张到跨路径ELF/MAP一致。BIN哈希与前节及交付表一致 |
| 运动中采样超期 | `tests/app_harness.c`新增CCR1>0前置断言，推进30ms，检查双CCR0及FAULT_SENSOR；恢复样本/清错/重新启动后再次CCR1>0才继续TX满STOP测试 | 前节保留的“只有已停状态App超期断言”缺口关闭，且两App测试包含在22项通过日志 |
| 清错后的旧半帧START | `tests/protocol_harness.c`新增故障→清错→旧时间戳START跨批次续帧仍STOP→新时间戳START接受 | 前节清错旧命令覆盖限制已补于协议层，不再列为完全无测试；非全部并发时序穷尽证明 |
| 控制时间参数集中 | app_config按采样最短/最长、速度单位、控制周期/最大间隔分别定义10/20ms常量，相关模块引用 | 与最新双轴审查关闭说明一致，未混淆不同参数语义；数值不变 |

本轮核阅的新增HTTP测试为`tests/test_panel_http.py::test_sim_routes_and_rejected_input`：启动真实本地HTTPServer，经urllib请求→Session→C模拟库，检查SIM端口、连接、新鲜状态、遥控、越界拒绝、STOP和重连停止；导出日志第99行记录该项ok。它确实增加了HTTP路径证据，但没有启动浏览器、运行页面JavaScript或操作DOM。

### 仍不能关闭的层级

- **真实Windows浏览器SIM界面：未完成。** 最新交付记录仍明确工具不能可靠确认URL而中止，未见成功UI执行记录。HTTP/Session/C模拟互通、JS语法检查和已存在HTML均不能替代按钮、按住/松开、焦点/可见性停车、参数快照下载等真实交互。P3及05/06整体验收继续保留此缺项。
- **真实蓝牙、DFU烧录、台架、实车：未执行。** 浏览器SIM即使后续通过，也只关闭无硬件界面层，不能推导真实COM、固件在芯片执行、电机行为或赛道通过率。
- **独立审计的验证边界：** 本轮核阅已有两次执行日志并亲自只读比较4对BIN/HEX哈希，没有第三次重建或重跑测试。8产物同路径重建一致仍属于81f56c3阶段记录；4c90a5b新增证据是导出源码构建及跨目录BIN/HEX一致，不能合并成“4c90a5b跨目录8产物均相同”。

截至本次读取，之前可修复的代码/测试发现均有关闭证据；P1/P2的构建与自动验证证据加强，P4/P5保持已覆盖。**唯一明确未完成的课前软件功能验收仍是真实Windows浏览器SIM操作；因此不能宣称软件五项全部验收完成。** 最终交付应保留本地原始日志及提交后的验证记录；本轮不代改其他文档/票据、不提交、不跨对话发消息、不操作硬件。

## 2026-10-08最终关闭复核：用户Windows SIM实测

本节核对2026-10-07用户实际操作及其后保存的证据，取代前文“Windows UI仍未验”的当前状态，历史结论不删除。读取时HEAD为`96f4967cb0a7df5fab9d2aa9d73d20b05d19fbd1`；相对已验证实现`4c90a5b`，Core/panel/tests/Makefile无提交内容变化。实现方正在补最终交付记录和05/06状态，本审计只追加本文，不争写这些文件，也未重跑构建或测试。

### 证据分层

- **用户实际浏览器操作**：协调对话转来的用户确认是清单1–3可完成、4完成并保存快照、5三种故障模拟及第二次运动中取消心跳符合预期、6符合预期；随后确认1–6整体符合预期。第一次取消心跳时已处于停止状态，这是用户明确补充的事实。本审计不是操作见证人，不写成“代理亲自完成浏览器测试”。操作者为用户，Windows浏览器具体名称/版本未知；此项仅为环境记录缺失，不新增功能验收门槛。
- **直接读取的参数快照**：`tmp/smartcar-parameters.json`时间`2026-10-07T14:41:10.843Z`（北京时间22:41:10.843），port=SIM、mode0、fault0、PWM[0,0]、health7、stale=false，参数[4,20,5,20,2,0]，日志指向`20261007-223922-288342.jsonl`。支持实际保存了参数快照及当时状态；单张快照不证明所有操作时序，health7也不证明真实IMU已校准。
- **直接抽查的会话日志**：主日志第9334行记录STOP，第9337行为mode0/fault0/PWM0；第11842行为mode1/fault0，第11936行变为mode0/fault1/PWM0；第12786行在后续新启动后恢复mode1。邻近`20261007-224825-880394.jsonl`以SIM connect、STOP和参数读取开场，符合重连不自动运动的会话路径。日志没有勾选框/焦点来源记录，不自行归因某次STOP来自哪个UI事件。
- **实现方窄范围自动复现**：[心跳取消差异诊断](心跳取消差异诊断.md)记录同源C模拟器四组均通过；本轮读取`build/heartbeat-diagnosis/`四个JSONL的末次遥测，依次为STOP/fault0、STOP/fault0、STOP/fault1、STOP/fault1，PWM均0，与“本来停止”“先STOP”“循迹失联”“遥控失联”的记录对应。本轮没有再次执行这些复现。
- **此前自动验证与构建**：22项自动软件验证、真实双配置构建、4c90a5b独立导出构建及BIN/HEX一致，沿用上一节已核阅证据。此轮纯证据/文档收尾没有代码变化，不要求重复全量构建。

### 心跳反馈的判定

第一次已停止时取消心跳、不新增心跳故障，符合`Control_CheckTime`只对非STOP模式执行超时锁存的已确认契约；不要求停车状态凭空进入心跳故障。第二次运动中取消心跳发生停车并锁存，用户确认与日志相符。因此不是用第二次成功掩盖第一次失败，也没有足够证据要求改固件。日志约605ms接收时差含遥测/主机调度，不能把它解释为固件阈值改为605ms或精确机械停车时间。

### P1–P5关闭结论

| 项目 | 本次最终判断 |
|---|---|
| P1 F407工程、真实依赖、可重复构建及产物 | 已满足课前软件交付；真实双目标构建与独立导出证据保持有效 |
| P2 控制/协议主机测试 | 已满足；原03/04发现及补测已有关闭依据，自动测试边界不扩大到硬件 |
| P3 Windows面板与无硬件模拟验证 | **已满足**；原缺少的实际界面证据由用户SIM实操确认、快照和日志补齐，结合已有Session/HTTP/C模拟验证可关闭 |
| P4 DFU说明、现场表、参数/日志方式 | 已满足；文档已交付，参数快照与日志保存另有用户操作证据，现场表不填虚构实测 |
| P5 分层报告 | 已满足证据要求；本节明确用户实操、代理自动验证与实物未验的区别。由实现方同步最终报告/票据，避免旧“UI未完成”继续充当当前结论 |

**课前五项软件交付的实质验收条件已满足，05/06具备关闭依据。** 本轮未发现新增代码缺陷；无需因浏览器版本未知或仅文档更新重复构建。其他报告/票据的状态同步由实现方负责，本节不声称已代为改完或提交。

关闭范围仅为课前软件交付：实际蓝牙/SPP、DFU烧录校验、板级电气/时序、传感器与编码器物理标定、电机/机械停车、台架与实车赛道均仍未验证，留课堂执行。SIM中的轮速、PWM、故障和校准状态不等于实车表现，后续十字/T字识别与赛道成功率目标不因软件验收而关闭。未烧录、未运行电机、未推送。
