leoy32255/SmartCar/docs/archive/2026-10-20/README.md

# 2026-10-20整理前的历史说明快照

这里保存统一流程整理前的14份原文，包括根README及原docs说明。正文中的状态、哈希和“后续”属于原记录时点；为方便追溯，仅增加归档提示并调整Markdown链接路径。**当前执行请读[统一流程](../../上手与实物联调流程.md)。**

| 历史内容 | 原文 |
|---|---|
| 原根README，含F103/TB6612旧方案 | [根目录README](根目录README.md) |
| 旧CubeMX/F103生成与早期移植 | [CubeMX配置说明](CubeMX配置说明.md)、[移植到F407VET6](移植到F407VET6.md) |
| F407早期板级与电机里程碑 | [最小构建](F407最小构建.md)、[2026-09-29构建记录](F407构建验证.md)、[电机驱动迁移](F407电机驱动迁移.md) |
| 原操作说明与现场预算 | [Windows控制面板](Windows控制面板.md)、[课堂135分钟检查表](课堂135分钟检查表.md) |
| 软件任务、最终签收及独立审计 | [工作安排](软件交付工作安排.md)、[交付验证](软件交付验证.md)、[覆盖审计](软件验收覆盖审计.md)、[心跳差异诊断](心跳取消差异诊断.md) |
| 整理前的集中参考 | [原引脚表（含F103）](引脚分配.md)、[原协议与控制](F407协议与控制.md) |

2026-10-07的软件22项验证与双目标构建、10-08用户SIM反馈属于已有证据。它们不代表DFU、真实COM、电源、传感器、电机或实车验收。早期记录“没有ST-Link”等已由2026-10-20用户补充更新；当前已有V2。

这些记录按阶段追加，前后可能有“尚未完成”与“已完成”；追溯状态时读其最终日期，不能把早期缺口当作当前待开发功能。原始参考PDF及JSON附件仍保留在[reference](../../reference/智能三轮循迹小车_逐引脚接线图_修订3.pdf)所在目录。
