leoy32255/SmartCar/docs/archive/2026-10-20/F407构建验证.md

> 历史快照：2026-10-20整理时归档，保留原阶段状态；下文不代表当前操作流程。当前执行请读[统一流程](../../上手与实物联调流程.md)。原正文保留，文档链接仅调整为归档后的可达路径。

# F407最小构建验证记录

日期：2026-09-29。范围为本轮用户确认的板级最小构建，不代表完整课堂软件交付。

## 已执行

| 层级 | 命令/证据 | 结果与边界 |
|---|---|---|
| 真实交叉编译 | `make clean`，`make -j8 test` | GCC for STM32 14.3.1、GNU Make 4.1；无编译/链接警告，产出ELF/HEX/BIN/MAP |
| 主机板级边界 | `test_bsp_host.py` | MinGW GCC 8.1，执行真实BSP并模拟HAL/MMIO，检查初始化与停车；不运行真实HAL硬件逻辑 |
| 产物检查 | `test_f407_image.py` | 三项通过：内存边界、向量归属、真实运行库及HEX校验和 |
| 依赖完整性 | `test_vendor.py` | 71个官方文件与固定commit导入时的SHA-256一致 |
| 干净重建 | 第二次 `make clean`、`make -j8` | 同一工具链/路径下BIN与ELF逐字节一致；不宣称跨工具链调试ELF一致 |
| 提交源码独立构建 | `git archive`导出实现提交39b91e2，在新目录 `make -j8 test` | 不依赖本地未跟踪文件；5项测试通过，BIN与工作目录一致 |
| F1历史语法回归 | Git Bash `.ci_check/check.sh F1` | 本机gcc实际执行，12个文件通过，无警告；不是F1真实交叉编译 |

首次产物测试因不存在BIN失败；补齐构建后通过。初次F1预检因Bash PATH缺少dirname/sed/head失败，补全该进程PATH后实际重跑通过；未把失败或跳过记为通过。

## 产物

- `build/F4/SmartCar.bin`：7172 bytes；SHA-256 `eba80f87e13be1e97690ea4f0ce4462ea270862a0cbdfa5d8485513d09b3153d`。
- `build/F4/SmartCar.elf`：SHA-256 `a5d0a974dea491946c80ebce95aff0b9cf2ea44f2273aa5daf17fc119e2af528`（包含本地调试路径）。
- Linker占用：Flash 7172/524288 bytes；普通SRAM 2528/131072 bytes，含2048 bytes栈预留；CCM 0。
- `readelf -l`：Flash段R-X，数据/BSS段RW-，无RWX LOAD段。
- Reset、SysTick、TIM6_DAC、EXTI15_10、USART2向量对应实际处理器；TIM4/EXTI0保留启动文件默认弱处理器。

## 未执行

DFU枚举、下载与校验、上电、台架、传感器读数、实际PWM/中断时序、电机与实车。仅软件配置满足图纸，不推断实物接线和动态表现。完整控制/协议及其测试属于后续实现。

## 双轴代码审查

基线 `76239a8f9d14fa870b4087e9364c2e36c8bfce1d`，审查实现提交 `39b91e270e414f808278539c82ac226ceff0523e`，由两个独立只读审查执行。

### Standards

0项：未发现可操作的项目规范违反或启发式代码异味。检查了启动/链接兼容性、源文件选择、中断归属、安全GPIO初始化、依赖导入/哈希、主机测试及验证文档。无静态可见的具体正确性缺陷；文档区分了软件与未执行的硬件验证。

### Spec

0项：符合已确认的最小构建范围，包括真实固定依赖、F407VE内存布局、8MHz至168MHz时钟、TIM1 PWM、TIM3/TIM4编码器、TIM6节拍、唯一IRQ归属、修订3引脚及停车初始化。控制/协议、传感器事务、心跳和面板按用户确认留待后续，不算本票遗漏。

两项审查仅为源码与测试契约审查，未独立重跑测试或执行硬件操作。总计Standards 0项、Spec 0项，无未处理审查发现。
