leoy32255/SmartCar/docs/archive/2026-10-20/课堂135分钟检查表.md

> 历史快照：2026-10-20整理时归档，保留原阶段状态；下文不代表当前操作流程。当前执行请读[统一流程](../../上手与实物联调流程.md)。原正文保留，文档链接仅调整为归档后的可达路径。

# 首次课堂135分钟检查表

日期____ 执行者____ 记录者____ 板型号/批次____ 接线图版本____
固件目标（诊断/运动）____ Git提交____ BIN SHA-256____
电脑/系统____ 蓝牙COM____ 工具版本____ 实际电源版本____

每项填通过/失败/未做；失败先排查，不为赶时间跳过。无硬件时本表所有实测栏留空。停止输出与机械停稳分别计时。图纸步骤不代表已操作。

| 预算 | 操作/输入 | 预期与观察重点 | 实测/时间 | 结果/执行者/问题 |
|---|---|---|---|---|
| 0–40 | 断电核对物料、线序、主控板原理图 | 板载引脚占用、BOOT资料、XY版本、实际电源版本明确 | ____ | ____ |
| 0–40 | 对照修订3供电与共地 | 主控不并联外部3.3V；USB5V与外部5V不直接并供；动力支路/保险丝/粗线按图 | ____ | ____ |
| 0–40 | 动力断开时核验XY参考供电与方向上拉 | 确认该XY支持3.3V参考；未知前不接动力；记录电平 | ____ | ____ |
| 40–65 | 按板资料进入ROM bootloader | USB DFU枚举，记录实际BOOT/复位步骤，不能猜跳帽 | ____ | ____ |
| 40–65 | 首次下载诊断BIN并校验 | 地址0x08000000、文件哈希一致、校验成功 | ____ | ____ |
| 40–65 | 恢复Flash启动并复位 | 方向11、PWM0；分别记录上电前软件未运行阶段与运行后波形 | ____ | ____ |
| 40–65 | 蓝牙配对、COM连接、状态回传 | 9600/8N1、协议v1、诊断拒绝运动、日志路径可见 | ____ | ____ |
| 65–100 | 每路依次置白/黑，记录安装高度/间距 | bit0最左、黑=1；全白与拔下不能区分；断电插拔 | ____ | ____ |
| 65–100 | 静置观察IMU与校准 | 首个有效样本前无效，约1g合量，200新样本校准，记录零偏/方向 | ____ | ____ |
| 65–100 | 手转左右编码器 | 两轮前进计数正；记录每输出轴一圈counts（旧1320仅待核验） | ____ | ____ |
| 65–100 | 条件通过后另行下载运动BIN、架空逐轮低指令 | 方向/通道正确、2kHz、最小5%、默认控制封顶30%；复位仍停车 | ____ | ____ |
| 100–125 | 架空启动遥控并松开按钮、STOP | 指令归零/方向11/PWM0；记录请求→电气输出和机械停稳两段时间 | ____ | ____ |
| 100–125 | 关闭面板控制心跳 | >=500ms首次检查锁存停车；恢复心跳不动，清错不动，人工启动才动 | ____ | ____ |
| 100–125 | 停车后确认连接与传感器，再低速循迹丢线 | 首个全白观测停，宽线歧义停；不做带电热拔 | ____ | ____ |
| 100–125 | 记录疑似堵转检测适用性 | 有PWM无计数500ms的软件策略；是否做物理负载测试须另行确认，不以夹轮风险赶进度 | ____ | ____ |
| 125–135 | 导出参数JSON、保存JSONL、抄写问题 | 参数/固件哈希/未做项可追溯；条件许可才低速落地，不要求跑圈 | ____ | ____ |

## ROM DFU操作说明（只供现场执行）

F407使用系统存储器内置ROM bootloader，不要求本应用包含USB DFU类。先取得本核心板BOOT/复位/USB连接资料，与[ST AN2606](https://www.st.com/resource/en/application_note/an2606-introduction-to-system-memory-boot-mode-on-stm32-mcus-stmicroelectronics.pdf)的F405/407章节核对，再进入系统存储器启动。通过[STM32CubeProgrammer说明](https://dev.st.com/stm32cube-docs/prog/latest/en/index.html)选择USB连接，确认枚举与芯片信息，选择正确BIN，起始地址0x08000000，执行下载并校验。然后按板资料恢复Flash启动并复位。实际跳帽/按键顺序未知，本文不编造。

先用build/F4-diagnostic/SmartCar.bin，仅采样诊断不驱动；完成逻辑/方向验证准备后再由现场操作者决定使用build/F4/SmartCar.bin。下载过程断开动力或按已确认供电方案隔离，USB与外部5V不直接并供。DFU枚举、下载、校验、恢复启动均需独立填写。本轮软件工作没有执行这些步骤。

## 参数记录

| 名称 | 单位/默认值 | 本次值 | 验证状态/日期 |
|---|---|---|---|
| 基础速度 | counts/10ms，5 | ____ | ____ |
| 循迹Kp / Kd | /100标度，20 / 5 | ____ | ____ |
| 速度Kp / Ki / Kd | 每10ms，20 / 2 / 0 | ____ | ____ |
| 控制PWM封顶 | 千分比300 | ____ | ____ |
| 左/右电机反向 | bsp_f407.h，0 / 0 | ____ | ____ |
| 左/右编码器反向 | app_config_f407.h，0 / 0 | ____ | ____ |
| 黑低/通道反序/偏差符号 | 1 / 0 / +1 | ____ | ____ |
| 左/右CPR | counts/rev，未确认（历史1320） | ____ | ____ |
| IMU XYZ零偏 | raw，校准回传 | ____ | ____ |
| 搜线/航向辅助 | 当前未实现并禁用 | ____ | ____ |

日志文件____ 参数快照____ 故障复现输入____ 机械停稳时间____
本次未完成项____ 下次优先事项____
后续赛道另记线宽、弯曲半径、安装位置/高度；连续3圈、左急弯10次、右急弯10次、十字直行10次分别记录结果和失败，当前没有实车通过率。
