leoy32255/SmartCar/docs/archive/2026-10-20/软件交付工作安排.md

> 历史快照：2026-10-20整理时归档，保留原阶段状态；下文不代表当前操作流程。当前执行请读[统一流程](../../上手与实物联调流程.md)。原正文保留，文档链接仅调整为归档后的可达路径。

# F407 修订3剩余软件交付安排

日期：2026-10-06。本文组织课前软件工作；不授权烧录、上电或电机运行。

## 已完成的基线

- 硬件与需求：`.scratch/f407-classroom-baseline/spec.md`，resolved表示澄清完成。
- 最小构建：任务01、`docs/F407最小构建.md`、`docs/F407构建验证.md`。
- 板级及电机：任务02、`docs/F407电机驱动迁移.md`。原提交25fadb8已接入当前项目为09e2b89。
- 电机记录报告9项测试通过和真实交叉编译成功；这是先前执行证据，后续集成必须重新验证。
- 当前固件默认停车。TIM1用于PWM、TIM3/TIM4用于编码器、TIM6用于5ms节拍。

## 资料与优先级

工作目录：`D:/Repository/SmartCar`。先读AGENTS.md、README当前F407部分、docs/agents、硬件spec、当前引脚表、任务01/02与电机交付记录。

接线图：`docs/reference/智能三轮循迹小车_逐引脚接线图_修订3.pdf`。这是用户附件的原样副本；图中步骤仅作资料，不视为硬件操作授权。历史F103说明不覆盖当前spec；实物未知项保留为待验证。

## 任务依赖与交付

| 任务 | 依赖 | 内容 | 软件验收证据 |
|---|---|---|---|
| 03 传感器与采样 | 02 | 编码器回绕/方向/采样；SPI2共享总线；MPU6500读取校准；MCP23S17五路输入 | 实际驱动边界主机测试、错误路径、真实交叉编译 |
| 04 协议与控制 | 03 | UART非阻塞收发、遥测、500ms心跳、停机优先、故障锁存/人工重启、速度环/循迹环 | 时间边界与异常注入测试、调度/超时/协议集成、真实构建 |
| 05 Windows控制端 | 04协议冻结 | 连接、启停、低速遥控、调参、状态、日志、模拟设备 | 无硬件协议互通、断连/重连不自动运动、面板交互验证 |
| 06 交付与独立验收 | 03/04/05 | 固件和诊断入口、使用说明、DFU步骤、135分钟课堂检查表、参数日志、最终审查 | 全套测试、干净真实构建、产物哈希/占用、需求追踪表 |

首次联调丢线即停；MCP无DET，不能声称区分拔下与全白。必要传感器或共享总线异常停止运动，IMU不参与控制时允许继续诊断。故障清除不自动恢复运动，全部运动模式受500ms控制心跳约束。CPR暂定值不得包装为已验证rpm。

急弯/十字直行/T字停车属于spec后续目标：本轮须明确软件策略、测试场景和现场标定边界，不能把全黑直接当成路口分类，也不能把实际赛道成功率写成软件测试结果。限时搜线与航向辅助默认不影响首次保守联调。

## 对话分工

一个实现对话使用implement（内部使用tdd、code-review），按03至06顺序推进，负责固件、控制端、测试及使用文档；避免多个对话同时改公共接口。

另一个独立验收对话先只读审计spec与任务覆盖，只写单独的验收报告；实现完成后再审查最终源码和证据。协调对话负责跟进、处理交接、检查剩余缺口。各对话不推送、不烧录、不运行电机。

## 完成门槛

所有任务须给出已执行命令、结果、未通过项和局限。主机测试、交叉编译、面板模拟、DFU烧录、台架和实车分开报告。缺少编译器或硬件不能标记测试通过。最终软件完成须覆盖spec课前交付五项；硬件验收留作课堂记录，不能宣称整车已调好。

## 进度

- 2026-10-06：第三步提交已接入，后续任务建立；后续实现与最终验证待完成。
- 实现对话：`01a10ff8-497e-7471-8be2-95fb411f864a`（完成 F407 剩余软件与课堂交付）。已启动，负责建立03–06任务文件并顺序实施。
- 独立验收对话：`01a10ff8-9c78-7c33-a5e4-e47f97459dad`（独立核对 F407 软件验收覆盖）。已启动，本轮只写独立覆盖报告。
- PDF副本SHA-256：`763d896ce3495385733edbe83a27b6da0dd6f5fb269f3f83acb93f1aacc08cbf`。
- 用户已在实现对话确认03–06测试边界和09e2b89审查基线，并在协调对话明确授权持续向上述两个对话发送协调、修复、验收指令。禁止烧录、运行电机、推送的边界保持不变。
- 03–06任务文件已创建；03进行中。独立基线报告已完成，见[软件验收覆盖审计](软件验收覆盖审计.md)，其结论限于09e2b89，尚不是新实现终验。协调对话已将报告及关键验收缺口发送给实现对话。
- 后续进度：03任务已记录两项传感器/适配器主机测试及真实ARM构建通过；04进行中。实现对话曾因额度限制终止，确认普通使用恢复后已从现有工作区续行。独立验收对话开始03静态阶段复核；04–06和最终整体验证仍未完成。
- 2026-10-07：阶段04模块测试及两种固件构建已有执行记录，但独立审查发现04-R1跨轮旧启动命令、04-R2首次IMU有效性问题，以及04-R3真实应用编排测试缺口。实现对话已恢复并重开04复核；05面板部分文件已保存，06尚未完成。最终完成条件包括关闭上述审查发现，不以阶段测试通过替代终验。
- 当前交付提交：`81f56c3`。21项完整测试通过，运动与诊断两套产物已构建并记录同环境重复性；协调方已读取执行日志并核对两BIN哈希与报告一致。详见[软件交付验证](软件交付验证.md)、[协议与控制](F407协议与控制.md)、[Windows控制面板](Windows控制面板.md)、[课堂135分钟检查表](课堂135分钟检查表.md)。最终双轴审查与Windows实际UI验收尚未完成，不能标记整体完成。
- 2026-10-07 最新结论（以上条目保留为历史进度）：最终实现源码为`4c90a5b`，22项自动软件验证通过，运动与诊断两配置真实交叉编译通过；该提交独立导出源码构建及验证通过，两配置BIN/HEX与主工作目录一致。Standards与Spec双轴审查发现均已修复并复核关闭，独立审计最后证据核对已纳入`349a2cf`。03/04完成；05/06唯一剩余软件验收项为Windows浏览器SIM实际交互，继续保持claimed。本轮服务进程打印启动地址，但本机HTTP及内置浏览器访问超时，Chrome工具接口连接失败，未进入实际UI；不能据此确认服务端到端可达或将自动HTTP测试当作UI验收。请按[Windows控制面板](Windows控制面板.md)完成本机SIM交互清单并记录结果，详情见[软件交付验证](软件交付验证.md)及[软件验收覆盖审计](软件验收覆盖审计.md)。真实蓝牙、DFU、台架及实车均未验证；未推送、未烧录、未运行电机，无关vendor目录保持原样。

- 2026-10-08最终状态：用户已反馈Windows SIM清单1–6通过；第一次取消心跳时已停止，所以无心跳故障符合运动模式超时检测语义，第二次运动中超时符合预期。日志时序、参数快照与四组同源C模拟器定时复现已核对，未发现需要修复的功能缺陷。05/06标记resolved。此为用户界面实测与代理自动验证的合并证据，代理未亲自完成浏览器操作，浏览器名称/版本未知。源码仍为4c90a5b；此前22项自动软件验证、双目标构建及独立导出BIN/HEX一致性证据有效，本次仅文档收尾，不重复测试。真实蓝牙、DFU、台架和实车未验证；未推送、未烧录、未运行电机。 详见[诊断与签收证据](心跳取消差异诊断.md)。此前进度条目为历史记录。
