leoy32255/SmartCar/docs/archive/2026-10-20/软件交付验证.md

> 历史快照：2026-10-20整理时归档，保留原阶段状态；下文不代表当前操作流程。当前执行请读[统一流程](../../上手与实物联调流程.md)。原正文保留，文档链接仅调整为归档后的可达路径。

# F407修订3软件交付验证

2026-10-08最终状态：用户已反馈Windows SIM清单1–6通过；第一次取消心跳时已停止，所以无心跳故障符合运动模式超时检测语义，第二次运动中超时符合预期。日志时序、参数快照与四组同源C模拟器定时复现已核对，未发现需要修复的功能缺陷。05/06标记resolved。此为用户界面实测与代理自动验证的合并证据，代理未亲自完成浏览器操作，浏览器名称/版本未知。源码仍为4c90a5b；此前22项自动软件验证、双目标构建及独立导出BIN/HEX一致性证据有效，本次仅文档收尾，不重复测试。真实蓝牙、DFU、台架和实车未验证；未推送、未烧录、未运行电机。

## 执行环境与证据

Windows，Python3.13.5，GNU Make4.1，主机MinGW GCC8.1，GNU Tools for STM3214.3.1（20250623）。工具路径配置见F407最小构建。

2026-10-07执行`make clean`、`make -j8 test`：真实HAL/CMSIS双目标构建成功，无编译告警。首次全量测试21项中1项失败：历史产物断言将新F407 App_Init误判为旧应用；改为检查实际源路径和App_Step，重跑21项全部通过；审查补测后最终22项全部通过，无跳过（17.454s）。完整本地输出在build/verification.log。

| 层级 | 已执行/结果 | 限制 |
|---|---|---|
| 主机板级与电机 | 1 BSP、4电机极性组合，通过 | 模拟MMIO/HAL；无电气波形 |
| 传感器/UART | 3项：寄存器驱动、HAL片选、UART队列，通过 | 寄存器/CS契约与错误注入，不是芯片实测 |
| 控制/协议 | 2项公开接口测试，通过 | 多场景断言在各harness中，不把2当场景数 |
| 真实App链路 | 运动/诊断2项，通过 | 实际app/IRQ/uart/sensor/motor源码；模拟时间和外设 |
| 产物 | 4项：内存、向量、实际应用、诊断无运动符号，通过 | 检查真实ARM产物，不执行Cortex代码 |
| 依赖 | 71个固定ST文件哈希完整性1项，通过 | 无修改HAL/CMSIS |
| 面板模拟 | 4项Python Session↔同源C模拟器，另1项HTTP→Session→C模拟器，通过 | 参数、心跳、重连、故障、日志；无浏览器交互证明 |
| Windows界面 | 用户反馈清单1–6通过 | 代理核对日志/快照并执行四组定时复现；浏览器版本未知，不代表硬件验证 |
| DFU/台架/实车 | 均未执行 | 未连接真实COM、未烧录、未运行电机，未推送 |

最终测试总数22 = 1+4+3+2+2+4+1+5。测试命令自身真实执行，不以退出码掩盖编译器缺失。早期沙箱内GCC出现DLL重定位错误，使用获准沙箱外编译测试；两次额度导致审批服务未能执行的命令均在恢复后重跑，不计为通过。

## 产物

运动入口build/F4；诊断入口build/F4-diagnostic。每个目录均有ELF/HEX/BIN/MAP。Flash512KiB，普通SRAM128KiB，CCM64KiB独立未用。

| 目标 | Flash | 普通SRAM（含2KiB栈预留） | BIN SHA-256 |
|---|---:|---:|---|
| 运动 | 12648 B | 4360 B | bea52ea537a5c353bee9f460075d79f030214ac3b038b700668e452160e2171e |
| 诊断 | 12216 B | 4360 B | 987ca14f828a58fc0f2a65996b749ade5dfeb480d07cffb27121b79105805182 |

运动ELF SHA-256：8171c7cb4f47184ed3ed76a2bd7e0b36d9b6bdc787571e4a2a4ea17a9795bf40。
诊断ELF SHA-256：00a9ea1e56a6fb84cd5115cca67084ccb96f5afa34e054e3e55322cd32278bd9。
ELF含本地调试路径。栈预留不是测得的最坏栈深度。

## 独立阶段审计回应

保持独立审计报告原结论不修改。03-R1/R2补测见sensors_harness.c：199/200新样本、状态/数据失败、fresh与bias、不动/运动阈值、三轴负边界/温度、配置失败；MCP BANK恢复事务、逐路/高位忽略、初始化错误。sensor_port_harness验证CS精确路由与错误释放。

04-R1：protocol_harness先复现跨轮旧START复活，再加持续接收时间边界；app_harness由实际USART2_IRQHandler送STOP+半个START，跨轮补完仍停车。
04-R2：实际App测试先复现初始化即有效，再改成首次新数据才能有效；首个编码器完整窗口前也不能启动。
04-R3：提取交付代码App_Init/App_Step，实际ISR→队列→解析→调度→传感器→Motor/寄存器链路测试两编译模式。覆盖运动中SPI超时停车、首次样本、校准无新样本超时、采样超期、UART错误清半帧、跨轮STOP。额外覆盖两运动模式499ms保持运动、500/501ms实际PWM为0，以及运动中TX满仍处理STOP且增加丢帧计数。

## 课前五项追踪

| spec项目 | 证据 | 当前状态 |
|---|---|---|
| 1 F407工程、真实依赖、构建与固件 | Makefile双目标，Core/F407、引脚表、产物哈希/测试 | 软件完成；电气/板级实测未做 |
| 2 控制/协议有意义主机测试 | control/protocol/app/sensors/UART与电机harness | 自动测试通过；机械停止未做 |
| 3 Windows控制面板与模拟 | panel/，同源C模拟器、4项会话测试和1项HTTP测试 | 实现/协议模拟完成；用户UI清单1–6通过，蓝牙未测 |
| 4 DFU、现场表、参数日志 | 课堂135分钟检查表、Windows控制面板、F407协议与控制 | 文档完成；现场记录留空 |
| 5 分层报告 | 本文执行表与未验证范围 | 报告完成，不宣称DFU/台架/实车通过 |

后续十字直行/T字识别、限时搜线、航向辅助与赛道成功率不是已完成性能；当前只交付保守歧义停车和可追溯候选策略，详见协议与控制文档。无独立电流/温度传感器与硬件看门狗保证，疑似堵转仅软件计数策略。

## 可重复性

81f56c3阶段全量测试后执行第二次`make clean`、`make -j8`、`make DIAGNOSTIC=1 -j8`，两目标的BIN/ELF/HEX/MAP共8个文件SHA-256逐一相同。该结论仅适用于同工具链、同路径；未声称跨机调试ELF一致。面板JavaScript经`node --check`语法检查，通过；这不是浏览器UI实测。

## 最终双轴代码审查

以09e2b89为固定基线，审查实现81f56c3；两个只读子审查未运行硬件或另行构建。随后只读复核修复补丁。完整独立阶段报告见[软件验收覆盖审计](软件验收覆盖审计.md)，其历史结论按快照保留。

### Standards

未发现项目明文规范违反。1项P3维护性建议：编码器采样/归一单位、控制周期和样本年龄的10/20常量分散。已按不同语义分别集中到app_config_f407.h，并由三个模块引用；审查者只读复核确认关闭，数值及边界不变。

### Spec（审查时记录，UI收尾见末节）

1项P2测试覆盖缺口：原App采样超期场景在已停状态执行。已补CCR非零后延迟30ms，断言故障锁存与CCR0，再恢复/清错/人工重启到非零CCR后测试TX满STOP；审查者只读复核确认关闭。另补清错后旧时间戳半帧START仍被拒绝。审查当时Windows实际UI待验；后续用户实测已通过，详见最终签收。

合计：Standards 0项剩余发现（原1项P3关闭）；Spec 0项剩余代码/测试发现（原1项P2关闭），审查当时另有1项实际UI验收待办。后续用户实测已补齐，05/06现已resolved。

## 已提交源码独立验证

从`4c90a5b5b4de1b50be6ed2b4b9ab437317c5d028`执行`git archive`导出全新目录`build/source-4c90a5b`（不含.git、build或未跟踪vendor目录）。在该目录执行`make -j8 test`，真实运动/诊断构建、主机模拟库现编、22项测试全部通过（24.529s）。两目标BIN及HEX均与工作目录逐字节一致。ELF/MAP含不同导出路径，不宣称跨路径一致；上表ELF哈希是主工作目录产物。源码和产物实现绑定4c90a5b；后续提交仅追加本验证记录。

本地证据：build/verification.log、build/source-verification.log、build/rebuild.log。全部未推送；无关tmp/vendor-*保留。独立审计原文已纳入4c90a5b。

## 历史：当时唯一剩余软件验收项（已由后续用户实测关闭）

实际Windows浏览器SIM交互尚未完成。工具返回“could not determine the current browser URL on Windows with enough confidence to enforce policy”，中止本轮Computer Use；没有绕过，也没有将HTTP/协议测试当UI实测。手工清单见Windows控制面板文档：连接SIM→等待新鲜遥测→循迹/遥控→STOP→停车调参回读→故障注入与清错→关闭心跳→断开重连保持停止→保存参数快照/查日志。记录操作者、浏览器版本、每项结果后才能关闭05/06。用户尚未提供这项实操结果。

### 2026-10-07 浏览器重试记录

按更新后的浏览器工具重试：首次内置浏览器返回ERR_CONNECTION_REFUSED；随后启动仅绑定127.0.0.1的SIM服务，进程打印启动地址且仍保持运行，但内置浏览器返回ERR_CONNECTION_TIMED_OUT。Chrome入口返回nodeRepl.fetch request failed。沙箱内HTTP检查报告套接字权限限制；沙箱外HTTP检查也在5秒后超时。因此仅确认服务进程启动，不能确认其端到端可达，也不能断言先前服务已经停止或问题完全属于浏览器。未连接真实COM，未进入实际UI，未绕过限制，停止继续重试。独立审计最后核对已纳入文档；原22项测试及导出构建证据保持有效，无需重复执行。

剩余最小操作：在本机按Windows控制面板文档启动服务并打开页面，仅选SIM，完成上述交互清单并记录结果；若本机浏览器也无法打开，先保留服务终端报错用于定位。实际UI通过前05/06仍为claimed。

## 最终签收（2026-10-08）

2026-10-08最终状态：用户已反馈Windows SIM清单1–6通过；第一次取消心跳时已停止，所以无心跳故障符合运动模式超时检测语义，第二次运动中超时符合预期。日志时序、参数快照与四组同源C模拟器定时复现已核对，未发现需要修复的功能缺陷。05/06标记resolved。此为用户界面实测与代理自动验证的合并证据，代理未亲自完成浏览器操作，浏览器名称/版本未知。源码仍为4c90a5b；此前22项自动软件验证、双目标构建及独立导出BIN/HEX一致性证据有效，本次仅文档收尾，不重复测试。真实蓝牙、DFU、台架和实车未验证；未推送、未烧录、未运行电机。

详见[心跳取消差异诊断](心跳取消差异诊断.md)和[验收参数快照](../../reference/smartcar-parameters-20261007.json)。上述历史待办不再代表当前状态；保留其原始证据边界。
