leoy32255/SmartCar/docs/reference/toolchain-versions-20261020.png

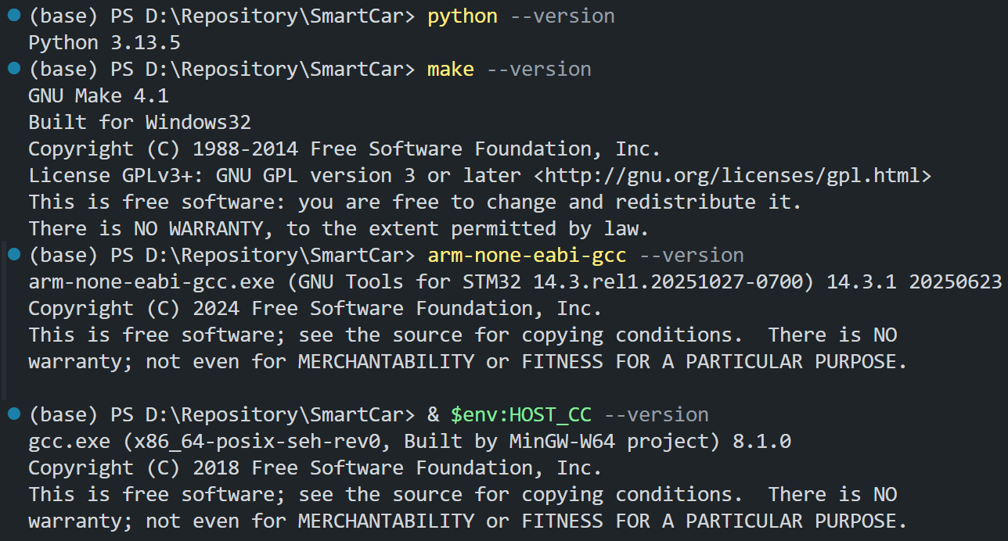
docs/reference/toolchain-versions-20261020.png
