leoy32255/SmartCar/tmp/wiring.txt

智能三轮循迹小车 · 逐引脚接线图                                                                                                                 XY-160D：新增PE8、PE13；PWM改为2kHz
                                                                                                                                  待确认：本款“+5V”参考脚允许3.3V供电，再接电机。
STM32F407VET6 | 2×520 编码器电机 + 万向轮 | XY-160D 修订3 | 2026-09-24

 1     先接供电：电机与控制电路分两支
 图中：红 = 电池正极；橙 = 5V；绿 = 3.3V；黑 = GND；蓝 = 信号。电机实物线色按第2框。同名电源与GND须连通。
                                                                         XY-160D 电源+ ← 电池正极                        电机电源不走降压板 Vout=Vin、板载开关、面包板或杜邦线。
     3S 电池：11.1V / 满电 12.6V           正极 → F1保险丝 → S1总开关                 旁路 470–1000μF / 35V：正接+、负接-               外部3.3V不要接主控3V3；主控由自身稳压器供电，避免并联稳压器。
     建议 ≥10A 持续 / ≥15A 短时             F1初选5A慢断；S1 ≥15VDC/10A
     成品保护电池 + 配套充电方案                  按实测启动电流校核保险丝                       降压板 IN+ ← 电池正极（6–24V）                     5V → 主控5V + MPU模块VCC + JDY-31载板VCC
                                                                         5V 与 3.3V 输出先空载测量                         3.3V → 两编码器 + 循迹板 + MCP23S17
 电池负极                                                                    GND 共地：XY的PGND及控制GND、降压 IN-/GND、主控、传感器、蓝牙均连接

 2     XY-160D + 左右编码器                                         3   可拔循迹：7线接口 J_LINE · 不用DET                                          4   MPU6500 模块 · SPI
 按板上功能名接线；ENA1=ENA，ENA2=ENB（有的两列都印ENA）。                        保留VCC、GND和OUT1–5；MCP23S17留在底板。整车断电后插拔。                               使用模块丝印针名；VCC有板载稳压，信号仍为3.3V。
 STM32 针名                     XY-160D 信号针                      底板这一侧                       J_LINE           传感器这一侧                  PB13 / SCK              SCL（即SCLK）
 PE9 / TIM1_CH1                ENA1 / 左PWM                                                    1
                                                               3.3V 电源                                      VCC（丝印5V）               PB15 / MOSI             SDA（即SDI）
 PE10 / GPIO                   IN1 / 左方向1
                                                               GND                            2             GND                     PB14 / MISO             AD0（即SDO）
 PE8 / GPIO（新增）                IN2 / 左方向2
                                                               U1脚21 / GPA0                   3             OUT1                    PB12 / GPIO             NCS
 PE11 / TIM1_CH2               ENA2 / 右PWM
                                                               U1脚22 / GPA1                   4             OUT2                    PB10 / EXTI10           INT
 PE12 / GPIO                   IN3 / 右方向1
 PE13 / GPIO（新增）               IN4 / 右方向2                                                     5                                     VCC → 5V；GND、FSYNC → GND；EDA、ECL不接。
                                                               U1脚23 / GPA2                                 OUT3
 信号“+5V” → 核心板3V3*；控制GND → 主控GND。                                                                                                   NCS经10kΩ上拉到3.3V；先核实模块稳压输出≈3.3V。
                                                               U1脚24 / GPA3                   6             OUT4
 * 先确认该版支持3.3V参考供电；未确认前不接电机电源。
 IN1–4各10kΩ上拉核心3V3；移除原两个PWM下拉。                                 U1脚25 / GPA4                   7             OUT5
 左：红1→OUT1、白6→OUT2；右：红1→OUT3、白6→OUT4。                                                                                                5   UART · JDY-31 蓝牙从机
                                                               U1脚28 / GPA7 不接线，设输入上拉；软件忽略bit7。
 两台：蓝5→外部3.3V；黑2→GND；电机两端各并100nF。
                                                               OUT1–5：各用10kΩ上拉到3.3V（共5只，装在底板）。                                      PD5 / USART2_TX          RXD
 左：黄3 / 绿4                     PC6 / PC7 · A / B
                                                               J_LINE编号是本方案自定义，必须标记1脚；不是原板7P物理顺序。                                   PD6 / USART2_RX          TXD
 右：黄3 / 绿4                     PD12 / PD13 · A / B
                                                               先测OUT：高 ≥2.64V、低 ≤0.66V。黑线通常为0；按实测校准。
 方向11=高阻滑行；00=刹车。开机先保持11，再把ENA置0。                                                                                                   载板VCC → 5V；GND → 共地；STATE、EN不接。
 白线不是GND；蓝线不能接12V；不把弱下拉当作可靠禁能。                                 无自动在位检测：拔下与全白可能同为全1，确认连接后再启动。                                        默认9600；先按8N1联调；无需CP2102。

 6     主控与软件设置                                                 7   U1 = MCP23S17-E/SP · DIP28 最小接线                                   8   上电前 / 调试顺序
 下列为STM32芯片功能，不代表主板排针的行列编号。                                    必须是带 S 的 SPI 型号；缺口朝上：左上1脚，逆时针编号。                                     ① 断电断开动力支路，先核验XY的3.3V参考。
 PE9、PE11：AF1 / TIM1，2kHz；168MHz时PSC=83、ARR=999。
                                                               PB13 → 12 SCK                      15 / A0、16 / A1、17 / A2 → GND
                                                                                                                                    ② 只上逻辑电源：测高低电平；断电后接回动力。
 PE8、PE10、PE12、PE13：普通输出，先置1（高阻停车）。
                                                               PB15 → 13 SI / MOSI                18 /RESET → 10kΩ → 3.3V
 PC6、PC7：AF2 / TIM3_CH1、CH2，左编码器AB。                                                                                                 ③ 初始化方向11、ENA=0，检查通过后才使能。
                                                               PB14 ← 14 SO / MISO                11 /CS → 10kΩ → 3.3V
 PD12、PD13：AF2 / TIM4_CH1、CH2，右编码器AB。                                                                                               ④ SPI先Mode0；先初始化IMU，再访问MCP。
 PB13、PB14、PB15：AF5 / SPI2；PD5、PD6：AF7 / USART2。               PE7 → 11 /CS                       9与10脚间，就近并100nF
                                                                                                                                    ⑤ 架空轮子，以5%起调，检查单轮方向和AB。
 先用5%–95%调速；停止置ENA=0且方向11，100%另设。                              3.3V → 9 VDD；GND → 10 VSS          19 INTB、20 INTA：不接
                                                                                                                                    ⑥ 低速落地：验证温升、压降及丢线/堵转停机。
 SWD：PA13/DIO → SWDIO；PA14/CLK → SWCLK；GND共地。
                                                               1–8 / GPB0–7，26–28 / GPA5–7：不接线，软件设输入上拉。                             656.25kHz要求APB1=42MHz、SPI分频64；
 正规调试器VTref → 主控3V3（仅检测）；不接克隆器电源输出。
                                                               21–25见上方J_LINE；两片CS默认拉高；只使用输入bit0–4。                                 SPI时钟不是168MHz主频，也不是电源1.5MHz。
 保留PA0按键、PA1 LED、USB、晶振；TFT/OLED接口先不接屏。

 条件：XY“+5V”须允许3.3V参考供电；控制高≥3.0V、低≤0.8V，每脚灌电流≤8mA。电池能力仍需复核。
 外部5V供电时，勿同时接主控USB的5V！电机用粗线；信号约15cm内。断电插拔。配套说明：兼容性核查与接线说明.md。

依据：用户XY-160D三张参数图及电机6线图；ST DS8626；TDK MPU6500；Microchip DS20001952；DFRobot同类板参考供电说明。
