leoy32255/SmartCar/tmp/pdfs/wiring-review.png

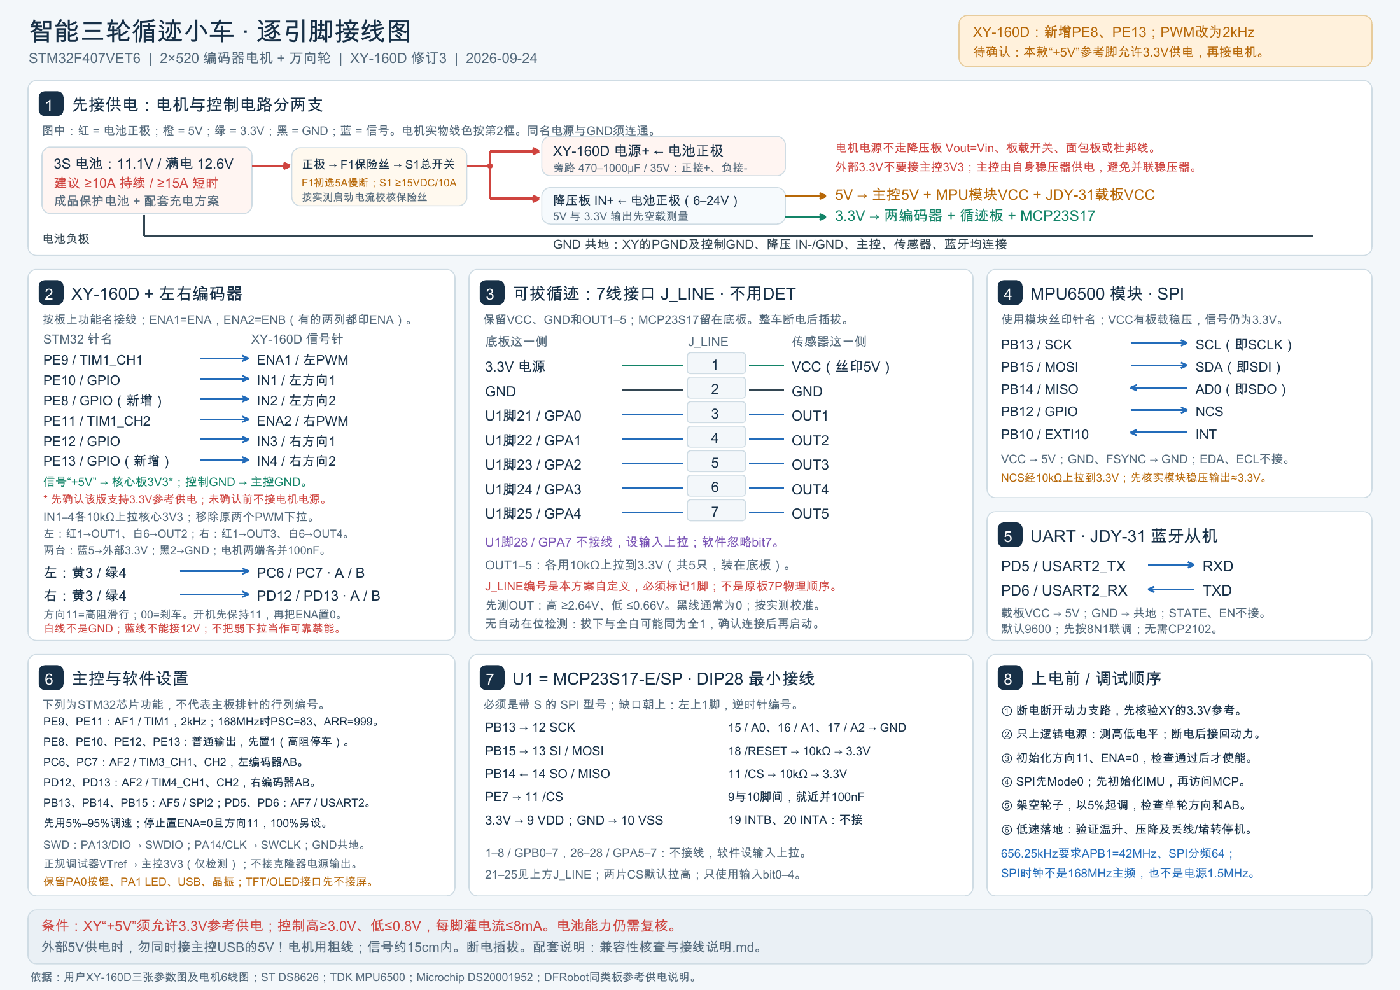
tmp/pdfs/wiring-review.png
