leoy32255/SmartCar/.scratch/f407-classroom-baseline/issues/02-board-motor.md

# F407 板级配置与 XY-160D 电机驱动迁移

Status: resolved
Blocked by: 01

## Scope

依赖 `01-minimal-build.md`（resolved），沿用修订3硬件基线。当前HEAD
`4be551ed7bd65c7d99cf03c5ba6589a57f0cdfb0` 已有真实F407依赖、时钟、引脚、
TIM1 2kHz、TIM3/TIM4编码器、TIM6 5ms及安全初始化；本票完成电机运行接口。
不接入旧应用、传感器事务、运动协议或闭环，不烧录、不运行电机。

## Acceptance

- 保留 TIM6 节拍与 TIM3/TIM4 编码器的独立归属及已确认接线。
- XY-160D：左PE9 PWM、PE10/PE8方向；右PE11 PWM、PE12/PE13方向。
- 带符号千分比指令；正向10、反向01为软件约定，实车方向待校准。
- 按图纸初期5%–95%：绝对值1..49归零，50..950原值，超过950限幅。
  零值、禁用、初始化使用方向11/PWM0，不提供00动态刹车或100%模式。
- 默认禁用；显式使能只解除禁止，不恢复旧指令；Stop撤销使能。
- 换向先进入11并清除旧PWM预装载，之后新方向配新占空比。
- 实际主机测试、真实F407交叉编译、双轴审查，分别报告硬件未验证项。

## Comments

- 2026-10-05：已读spec、01任务、构建记录及修订3PDF全文/整页图像。当前工作区干净。
- 2026-10-05：变更前 `make -j8 test` 5项通过；Flash7172B、SRAM2528B（含栈）。
- 2026-10-05：用户同意电机公开接口→方向/PWM限幅/零值/默认禁用/重新使能测试接口，
  沿用板级初始化、构建产物测试，审查基线为本次开始HEAD。

## Answer

实现XY-160D独立F407驱动；沿用已完成的TIM6/TIM3/TIM4资源分配，保留诊断固件默认禁用。
接口、5%–95%边界、INT16_MIN限幅、极性校准、换向UG刷新与停机/重新使能均有主机覆盖。
`make -j8 test` 9项通过，真实F407构建ELF/HEX/BIN/MAP，Flash7220B、SRAM2536B（含栈）。
两个独立静态审查：Standards 0项、Spec 0项。详见 `docs/F407电机驱动迁移.md`。
resolved表示本票软件实现/验证完成，不代表完整spec交付或实车验收。
未推送、未烧录、未运行电机。编码器算法、传感器、协议/心跳与控制集成仍属后续任务。
