leoy32255/SmartCar/.scratch/f407-classroom-baseline/issues/05-windows-panel.md

# Windows控制面板

Status: resolved
Blocked by: 04

## Scope and acceptance

连接、启停、低速遥控、参数、状态、日志；断连重连不恢复运动；无硬件模拟互通与界面验证。

## Confirmed seams

2026-10-06 用户确认传感器公开接口、控制/协议公开接口、面板连接/命令/日志及模拟互通。审查基线09e2b89。
不推送、不烧录、不运行电机；测试结果与现场验收分开。

## Comments

- 2026-10-06：读取基线、01/02记录和修订3PDF全文与整页图像后建立任务。

## Current result

2026-10-07：面板、日志和同源C模拟器实现；4项自动协议/会话/日志测试通过。Windows浏览器真实交互尚未通过，工具因URL不能确认中止，未绕过。保持claimed，等待实际UI验收；不把自动测试冒充界面通过。

## Answer

2026-10-08最终状态：用户已反馈Windows SIM清单1–6通过；第一次取消心跳时已停止，所以无心跳故障符合运动模式超时检测语义，第二次运动中超时符合预期。日志时序、参数快照与四组同源C模拟器定时复现已核对，未发现需要修复的功能缺陷。05/06标记resolved。此为用户界面实测与代理自动验证的合并证据，代理未亲自完成浏览器操作，浏览器名称/版本未知。源码仍为4c90a5b；此前22项自动软件验证、双目标构建及独立导出BIN/HEX一致性证据有效，本次仅文档收尾，不重复测试。真实蓝牙、DFU、台架和实车未验证；未推送、未烧录、未运行电机。

证据：[心跳差异诊断](../../../docs/心跳取消差异诊断.md)、[软件交付验证](../../../docs/软件交付验证.md)。此前claimed及待验表述为历史进度。
