leoy32255/SmartCar/.scratch/f407-classroom-baseline/issues/06-delivery.md

# 交付与验收

Status: resolved
Blocked by: 03, 04, 05

## Scope and acceptance

完整测试、干净真实构建、产物哈希/占用、双轴审查；DFU说明、135分钟检查表、参数日志、需求追踪；明确硬件未验证边界。

## Confirmed seams

2026-10-06 用户确认传感器公开接口、控制/协议公开接口、面板连接/命令/日志及模拟互通。审查基线09e2b89。
不推送、不烧录、不运行电机；测试结果与现场验收分开。

## Comments

- 2026-10-06：读取基线、01/02记录和修订3PDF全文与整页图像后建立任务。

## Current result

2026-10-07：协议/控制、Windows面板说明、DFU与135分钟填写表、软件交付验证已建立。21项全量测试通过、干净双目标构建且8产物重建哈希一致。Windows实际UI和最终审查仍待收口，不标resolved。

- 2026-10-07：双轴审查原Standards P3常量分散、Spec P2运动超期覆盖均已关闭；最终22项自动测试通过。剩余仅实际Windows UI验收与依赖05的最终签收；保持claimed。

- 2026-10-07：从4c90a5b独立导出源码，双目标真实构建与22项测试全部通过，BIN/HEX与主目录一致；独立审计原文已提交。05/06唯一剩余软件门槛为Windows实际SIM界面验收。

## Answer

2026-10-08最终状态：用户已反馈Windows SIM清单1–6通过；第一次取消心跳时已停止，所以无心跳故障符合运动模式超时检测语义，第二次运动中超时符合预期。日志时序、参数快照与四组同源C模拟器定时复现已核对，未发现需要修复的功能缺陷。05/06标记resolved。此为用户界面实测与代理自动验证的合并证据，代理未亲自完成浏览器操作，浏览器名称/版本未知。源码仍为4c90a5b；此前22项自动软件验证、双目标构建及独立导出BIN/HEX一致性证据有效，本次仅文档收尾，不重复测试。真实蓝牙、DFU、台架和实车未验证；未推送、未烧录、未运行电机。

证据：[心跳差异诊断](../../../docs/心跳取消差异诊断.md)、[软件交付验证](../../../docs/软件交付验证.md)。此前claimed及待验表述为历史进度。
