leoy32255/SmartCar/.scratch/f407-classroom-baseline/issues/03-sensors.md

# 传感器与采样

Status: resolved
Blocked by: 02

## Scope and acceptance

编码器16位回绕、方向与10ms采样；SPI2独占事务；MPU6500识别、原始数据与静止校准；MCP23S17全端口输入上拉及低5位黑线读数；错误路径主机测试与真实交叉编译。

## Confirmed seams

2026-10-06 用户确认传感器公开接口、控制/协议公开接口、面板连接/命令/日志及模拟互通。审查基线09e2b89。
不推送、不烧录、不运行电机；测试结果与现场验收分开。

## Comments

- 2026-10-06：读取基线、01/02记录和修订3PDF全文与整页图像后建立任务。

## Answer

2026-10-06：实际传感器接口与HAL片选适配器共2项主机测试通过，编码器双向回绕/方向、MCP配置和无DET读数、IMU识别/静止校准/运动拒绝、总线错误释放覆盖。真实ARM构建通过（Flash9472B、RAM2552B）。未上板；最终集成复验与双轴审查归06。
