leoy32255/SmartCar/.scratch/f407-classroom-baseline/issues/04-control-protocol.md

# 协议与控制

Status: resolved
Blocked by: 03

## Scope and acceptance

非阻塞UART；严格帧长度、校验及遥测；所有运动模式500ms心跳；停止优先、故障锁存、人工清除后重新启动；速度闭环及循迹PD；调度与错误注入。

## Confirmed seams

2026-10-06 用户确认传感器公开接口、控制/协议公开接口、面板连接/命令/日志及模拟互通。审查基线09e2b89。
不推送、不烧录、不运行电机；测试结果与现场验收分开。

## Comments

- 2026-10-06：读取基线、01/02记录和修订3PDF全文与整页图像后建立任务。

## Answer

2026-10-06：控制/协议公开接口、499/500/501ms与回绕、停车批次优先、锁存/清错、堵转、采样超期、歧义线路、异常帧及UART溢出/发送回绕主机测试通过。两套真实ARM固件构建通过。诊断固件不调用电机使能，运动固件默认STOP。最终集成与审查归06。

- 2026-10-07：按独立审计04-R1/R2/R3重开，补跨批次停止边界、首次样本及真实App编排测试。

- 2026-10-07：04-R1/R2先复现后修复；04-R3实际App/ISR到Motor两模式测试通过，运动中超时及TX满停车补测通过；21项全量测试通过，后续双轴审查归06。
