leoy32255/SmartCar/(commit log)

2026-10-06 feat: add safe revision-3 XY-160D motor driver for F407
2026-10-07 feat: integrate F407 sensors control protocol and local panel
2026-10-07 docs: record software delivery coordination and wiring reference
